rzele/TCC-Caixa-Preta/schemas/CXP 1p3/CXPcimaEbaixo3d.png

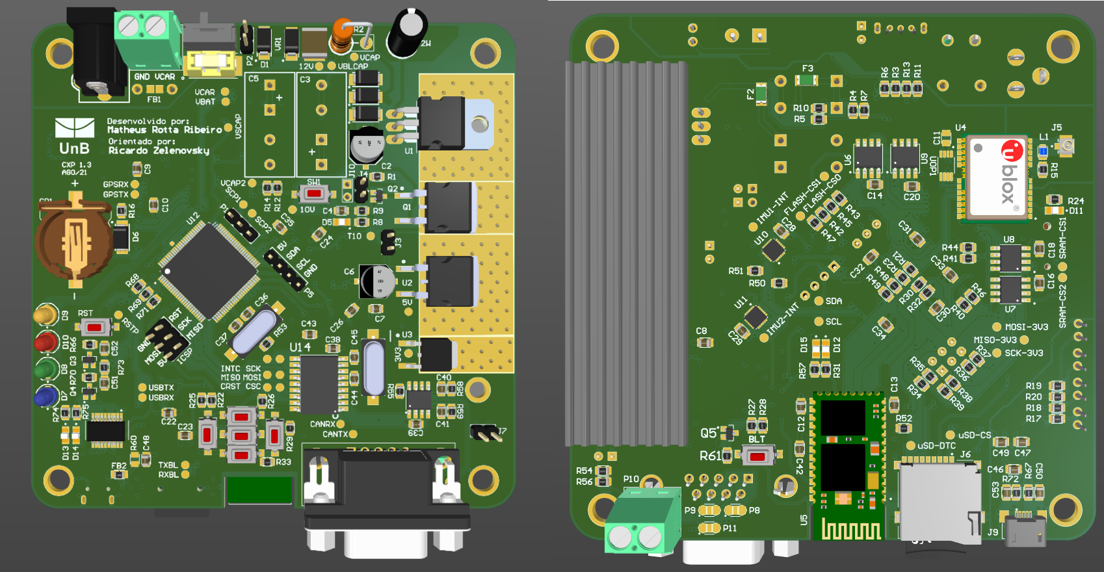
schemas/CXP 1p3/CXPcimaEbaixo3d.png
