rzele/TCC-Caixa-Preta/docs/Docs-2022/CXP.docx

CXP – Programa Caixa Preta (04/08/2020)

São duas as opções principais: Operação e Teste.

Operação: Ao ligar, entra normalmente em operação. Permite escolher um tipo de Operação para a Caixa Preta.

Teste: Entra em Teste se ligar a Caixa Preta com a tecla SEL acionada. Permite escolher rotinas para testar os diversos dispositivos da Caixa Preta e fazer novos ensaios.

Tudo pode ser comandado pela porta serial (eu espero!). Os comandos são letras (maiúsculas ou minúsculas) e números. O terminal do Arduino só os envia após o <Enter>.

Comandos seriais

Modo | Letra
- | T | Vai para o modo Teste
- | O | Vai para o modo Opera
- | Número | Inicia a opção com esse número
Opera 1: Adquirir dados | S | Inicia a aquisição (corresponde ao botão SEL)
| I | Interrompe a aquisição (corresponde ao INF)
| X | Sai do modo aquisição

----------------------- Distribuição da SRAM de 256 KB ---------------------------------

SRAM = 256 KB = 262.144

Mensagem GPS = 128 Bytes

Mensagem MPU = 18 bytes

Configuração = 416 bytes

Qtd msg MPU = 12.720 → 12.720 * 18 = 228.960 Bytes (127,2 segundos)

Qtd msg GPS = 254 → 254 * 128 = 32.768 Bytes (256 segundos)

262.144 – (256+32.768 + 228.960) = 160 bytes sobrando

Mapa da SRAM:

Finalidade | Faixa Hexa | Bytes | Qtd msg | Tempo
MPU | 0 0000 → 3 7E5F | 228.960 | 12.720 | 127 seg
Configuração | 3 7E60 → 3 7FFF | 416 | - | -
GPS | 3 8000 → 3 FFFF | 32.768 | 256 | 256 seg

#define MPU_ADR_INI 0x00000L

#define MPU_ADR_FIM 0x37E60L

#define CXP_ADR_INI 0x37E60L

#define CXP_ADR_FIM 0x38000L

#define GPS_ADR_INI 0x38000L

#define GPS_ADR_FIM 0x40000L

Unificação das Portas Seriais UART0 e UART2

UART0 --> Arduino

UART1 -->

UART2 --> Bluetooth

UART3 --> GPS

A CXP enxerga somente um canal serial.

Chegada: Não importa se vem de COM0 ou COM2, o dado é colocado na mesma fila.

Saída: toda vez que enviar um dado, ele sai pelas COM0 e COM2.

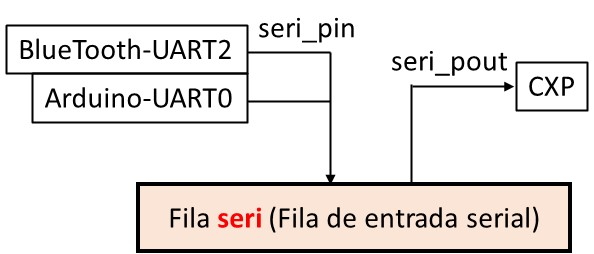
[picture p2: figure]
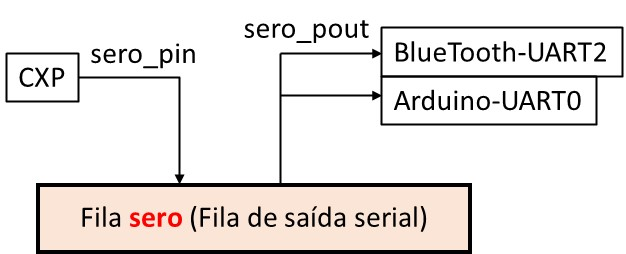
[picture p3: figure]

byte seri_fila[SERI_FILA_TAM] byte seri_pin,seri_pout byte seri_parou; void seri_config(void); byte seri_poe(byte dado) byte seri_tira (byte &dado) void seri_cheia(void) | byte sero_fila[SERO_FILA_TAM] byte sero_pin,sero_pout byte sero_parou; void sero_config(); byte sero_poe(byte dado) byte sero_tira (byte &dado) void sero_cheia(void)

--- SERI ---

Na chegada, interrupção da UART0 ou da UART2 chama seri_poe() e põe na fila. Não importa de onde veio.

Na saída, CXP usa seri_tira(), que deve desabilitar interrupções para tirar da fila.

--- SERO ---

Na chegada, CXP chama sero_poe(), para por algo na fila de saída (desabilitar interrupções para por na fila).

Na saída, Timer sempre reinicia a transmissão que acontece por interrupção até a fila esvaziar.

Interrupção TX UART0:

sero_cont++;

if (sero_cont==2){

if (sero_tira(&x) == TRUE){

UDR0=x; UDR2=x;

sero_parou=FALSE ; sero_cont=0;

}

else Sero_parou=TRUE;

}

Interrupção TX UART2:

Sero_cont++;

if (sero_cont==2){

if (sero_tira(&x) == TRUE){

UDR0=x; UDR2=x;

Sero_parou=FALSE; Sero_cont=0;

}

else sero_parou=TRUE;

}

Note que são duas unidades de saída UDR0 e UDR2. O dado a ser enviado é escrito em ambas. Um novo dado só pode ser enviado se ambas terminaram o envio anterior. A variável sero_cont garante isso, ela é zerada cada vez que um dado é escrito em UDR0 e UDR2. A primeira que termina incrementa sero_cont, que vai para 1. A segunda, ao terminar incrementa sero_cont, que vai para 2 e é autorizada a escrever novo dado a ser transmitido e zera a variável.

Quanto a fila sero fica vazia, sero_tira(&x) == FALSE então a transmissão deve parar por falta de dado. Mas faz a variável sero_parou=TRUE . O timer, se encontra a sinalização de que SERO parou, verifica se tem novo dado para retirar da fila, caso positivo, retira o dado e o escreve em UDR0 e UDR2, faz sero_parou=FALSE.

TIMER:

if sero_parou == TRUE{

if (sero_tira(&x) == TRUE){

UDR0=x; UDR2=x;

Sero_parou=FALSE Sero_cont=0;

}

else{

Sero_parou=TRUE; //Não precisa dessa linha

}

}

CALIBRAÇÃO DE FÁBRICA (CF)

É armazenada na EEPROM = 4 KB = 4.069 do processador AVR

Por Calibração de Fábrica se entendem parâmetros importantes para o funcionamento e que o usuário não vai alterar.

Uma calibração importante é a do erro intrínseco do MPU. Vamos deixá-lo ligado por um longo tempo (10 minutos) em um local estável, perfeitamente na horizontal, e depois fazer 1024 medidas espaçadas de acordo com a frequência da amostragem, calcular o erro intrínseco de cada eixo. Será importante armazenar o local onde foi feita a calibração e a aceleração da gravidade neste local.

Tabela na EEPROM com os dados da Calibração de Fábrica

(Todas strings são terminadas com zero ‘\0’)

(Valores de 16 ou 32 bits, grava-se primeiro o MSB “Big Endian”)

Bytes | Tipo | Exemplo | Nome | Descrição
| | | | Local e aceleração da gravidade
2 | 16 bits | SS | CF_OK | SS = já fez calibração, do contrário não
14 | string | dd/mm/aa | CF_DATA | Data da configuração
32 | string | Brasilia | CF_LOCAL | Local da configuração
16 | string | 9,80665 | CFG_PADRAO | Ac. da gravidade padrão (1g)
16 | string | 9,7808439 | CFG_LOCAL | Ac. da gravidade (m/s²) no local da configuração
2 | 16 bits | 0x3FFF | CFG_PADRAO_BIN | Ac. da gravidade padrão na escala de +/- 2g do MPU
2 | 16 bits | 0x3FD5 | CFG_LOCAL_BIN | Ac. da gravidade local na escala de +/- 2g do MPU
2 | 16 bits | 0x75 | CF_WHO | Resposta ao Who am I
- | - | - | - | Médias e Parâmetros usados
2 | 16 bits | 100 | CF_FA | Freq de amostragem usada (110, 200, ..., 1000)
2 | 16 bits | | CF_BW | Banda passante do filtro (5, 10, 21, ..., 260 Hz)
2 | 16 bits | | CF_ESC_AC | Escala usada para o Acelerômetro (2, 4, 8, 16)
2 | 16 bits | | CF_ESC_GI | Escala usada p/ o Giroscópio (250, 500, 1000, 2000)
2 | 16 bits | | CF_QTD | Quantidade de medidas para calcular a média
2 | 16 bits | | CF_AX | Erro do eixo ax (média)
2 | 16 bits | | CF_AY | Erro do eixo ay (média)
2 | 16 bits | | CF_AZ | Erro do eixo az (média) – ? descontado g local?
2 | 16 bits | | CF_TP | Temperatura média durante o cálculo
2 | 16 bits | | CF_GX | Erro do eixo gx (média)
2 | 16 bits | | CF_GY | Erro do eixo gy (média)
2 | 16 bits | | CF_GZ | Erro do eixo gz (média)
- | - | - | - | Somatórios
4 | 32 bits | | CF_AX_SOMA | Somatório no eixo ax
4 | 32 bits | | CF_AY_SOMA | Somatório no eixo ay
4 | 32 bits | | CF_AZ_SOMA | Somatório no eixo az
4 | 32 bits | | CF_TP_SOMA | Somatório das temperaturas
4 | 32 bits | | CF_GX_SOMA | Somatório no eixo gx
4 | 32 bits | | CF_GY_SOMA | Somatório no eixo gy
4 | 32 bits | | CF_GZ_SOMA | Somatório no eixo gz
- | - | - | - | Primeira e última medidas
2 | 16 bits | | CF_AX_PRI | Primeira medida no eixo ax
2 | 16 bits | | CF_AY_PRI | Primeira medida no eixo ax
2 | 16 bits | | CF_AZ_ PRI | Primeira medida no eixo ax
2 | 16 bits | | CF_TP_ PRI | Primeira medida de temperatura
2 | 16 bits | | CF_GX_ PRI | Primeira medida no eixo gx
2 | 16 bits | | CF_GY_ PRI | Primeira medida no eixo gy
2 | 16 bits | | CF_GZ_ PRI | Primeira medida no eixo gz
2 | 16 bits | | CF_AX_ULT | Última medida no eixo ax
2 | 16 bits | | CF_AY_ULT | Última medida no eixo ay
2 | 16 bits | | CF_AZ_ ULT | Última medida no eixo ax
2 | 16 bits | | CF_TP_ ULT | Última medida de temperatura
2 | 16 bits | | CF_GX_ ULT | Última medida no eixo gx
2 | 16 bits | | CF_GY_ ULT | Última medida no eixo gy
2 | 16 bits | | CF_GZ_ ULT | Última medida no eixo gz
- | - | - | - | Self Test
2 | 16 bits | | CF_ST_OK | Passou no Self-test? (TRUE=OK e FALSE=NOK)
2 | 16 bits | | CF_ST_OFF_AX | Leitura do eixo ax com Self Test desligado
2 | 16 bits | | CF_ST_OFF_AY | Leitura do eixo ay com Self Test desligado
2 | 16 bits | | CF_ST_OFF_AZ | Leitura do eixo az com Self Test desligado
2 | 16 bits | | CF_ST_OFF_GX | Leitura do eixo gx com Self Test desligado
2 | 16 bits | | CF_ST_OFF_GY | Leitura do eixo gy com Self Test desligado
2 | 16 bits | | CF_ST_OFF_GZ | Leitura do eixo gz com Self Test desligado
2 | 16 bits | | CF_ST_ON_AX | Leitura do eixo ax com Self Test ligado
2 | 16 bits | | CF_ST_ON_AY | Leitura do eixo ay com Self Test ligado
2 | 16 bits | | CF_ST_ON_AZ | Leitura do eixo az com Self Test ligado
2 | 16 bits | | CF_ST_ON_GX | Leitura do eixo gx com Self Test ligado
2 | 16 bits | | CF_ST_ON_GY | Leitura do eixo gy com Self Test ligado
2 | 16 bits | | CF_ST_ON_GZ | Leitura do eixo gz com Self Test ligado
2 | 16 bits | | CF_ST_REG_AX | Leitura do Reg de Self Test para ax (8 bits)
2 | 16 bits | | CF_ST_REG_AY | Leitura do Reg de Self Test para ay (8 bits)
2 | 16 bits | | CF_ST_REG_AZ | Leitura do Reg de Self Test para az (8 bits)
2 | 16 bits | | CF_ST_REG_GX | Leitura do Reg de Self Test para gx (8 bits)
2 | 16 bits | | CF_ST_REG_GY | Leitura do Reg de Self Test para gy (8 bits)
2 | 16 bits | | CF_ST_REG_GZ | Leitura do Reg de Self Test para gz (8 bits)
2 | 16 bits | | CF_ST_TOL_AX | Resultado calibração ax, tolerância de 14%
2 | 16 bits | | CF_ST_ TOL _AY | Resultado calibração ay, tolerância de 14%
2 | 16 bits | | CF_ST_ TOL _AZ | Resultado calibração az, tolerância de 14%
2 | 16 bits | | CF_ST_ TOL _GX | Resultado calibração gx, tolerância de 14%
2 | 16 bits | | CF_ST_ TOL _GY | Resultado calibração gy, tolerância de 14%
2 | 16 bits | | CF_ST_ TOL _GZ | Resultado calibração gz, tolerância de 14%
- | - | - | - | Magnetômetro – Calibração
2 | 16 bits | SS | CF_MAG_OK | SS = já fez calibração do magnetômetro
2 | 16 bits | | CF_STH_OK | Mag Passou no Self-test? (TRUE=OK e FALSE=NOK)
2 | 16 bits | | CF_STH_HX | Leitura de hx durante Self Test
2 | 16 bits | | CF_STH_HY | Leitura de hy durante Self Test
2 | 16 bits | | CF_STH_HZ | Leitura de hz durante Self Test
2 | 16 bits | | CF_HX_ASA | ASA de hx, Fuse ROM adjustment sensibility
2 | 16 bits | | CF_HY_ASA | ASA de hy, Fuse ROM adjustment sensibility
2 | 16 bits | | CF_HZ_ASA | ASA de hz, Fuse ROM adjustment sensibility
2 | 16 bits | | CF_HX_OFF | Offset de hx (dividir por 10) Hard Iron
2 | 16 bits | | CF_HY_OFF | Offset de hy (dividir por 10) Hard Iron
2 | 16 bits | | CF_HZ_OFF | Offset de hz (dividir por 10) Hard Iron
2 | 16 bits | | CF_HX_ESC | Escala de hx (dividir por 10) Soft Iron
2 | 16 bits | | CF_HY_ESC | Escala de hy (dividir por 10) Soft Iron
2 | 16 bits | | CF_HZ_ESC | Escala de hz (dividir por 10) Soft Iron

Note que as medidas CF_ST_REG_AX, ..., CF_ST_REG_GZ só precisam de 8 bits, mas foram reservados 16 bits para facilitar a leitura e o mapa.

As temperaturas inicial e final permitem ver se houve grande variação de temperatura durante a calibração

Ajustes do Magnetômetro:

ASAX, ASAY, ASAZ: Sensitivity Adjustment values (ASA tem apenas 1 byte e parece não ter sinal). Exemplo para hx, idem para hy e hz.

hx_(adj) =hx*(((ASAx-128)*0.5)/128+1)

CALIBRAÇÃO: Para ter um pouco de precisão, os valores de offset e ajuste estão multiplicados por 10. Então, primeiro é preciso dividi-los por 10 antes de usá-los.

hx_(aj) =(hx-hx_(off) )*hx_(esc)

hy_(aj) =(hyx-hy_(off) )*hy_(esc)

hz_(aj) =(hz-hz_(off) )*hz_(esc)

CALIBRAÇÃO AO LIGAR O CARRO

Toda vez que o carro for ligado, é executada a chamada “Calibração ao ligar o carro”. Ela será guardada na SRAM e copiada para a Flash em caso de acidente. Na SRAM (ou Flash) ocupa o bloco de 416 bytes (0x3 7E60 → 0x3 7FFF). Este bloco é marcado com as constantes:

#define CXP_ADR_INI 0x37E60L //Início área de config da Caixa Preta (sobram 416 bytes)

#define CXP_ADR_FIM 0x38000L //Fim área de conficuração da Caixa Preta

Para simplificar os acessos, os dados gravados nesta área são de 16 bits, 32 bits ou strings terminadas em zero. Mesmo quando a informação é de apenas um byte, usam-se 2 bytes. As duas constantes abaixo padronizam em 16 bits as possibilidades de sim ou não.

#define COD_SIM 0x5353 //2x ASCII(S) Afirmativo

#define COD_NAO 0x4E4E //2x ASCII(N) Negativo

Tabela 1. Parâmetros do Setor de Configuração ao Ligar e Operação (SRAM e FLASH).

Offset | Bytes | Tipo | Exemp | Nome | Descrição
0 | 2 | 16 bits | NN | OP_OK | Fez calibração ao ligar? OK / NOK
0 | 2 | 16 bits | NN | OP_BATEU | (NN) → pronta, (SS) → acidentada
2 | 2 | 16 bits | SS | OP_ST_OK | Self-Test: (SS) → OK, (NN) → NOK
2 | 2 | 16 bits | SS | OP_STH_OK | Self-Test Mag: (SS) → OK, (NN) → NOK
2 | 2 | 16 bits | SS | OP_CF_OK | Calib de Fabr: (SS) → OK, (NN) → NOK
2 | 2 | 16 bits | SS | OP_CFH_OK | Mag fez Calib de Fabr: OK, NOK
- | - | | | | Acel e Giro - Calibra ao ligar
4 | 2 | 16 bits | | OPC_FREQ_AG | Freq de amostragem (100,..., 1000 Hz)
4 | 2 | 16 bits | | OPC_BW_AG | Banda do filtro (5,10, ..., 260 Hz)
6 | 2 | 16 bits | | OPC_ESC_AC | Escala acelerômetro (1, 2, 4, 8 g)
6 | 2 | 16 bits | | OPC_ESC_GI | Escala giroscópio (250, ..., 2000)
4 | 2 | 16 bits | | OPC_QTD_AG | Qtd de medidas para a média
8 | 2 | 16 bits | | OPC_AX | Média AX
10 | 2 | 16 bits | | OPC_AY | Média AY
12 | 2 | 16 bits | | OPC_AZ | Média AZ
14 | 2 | 16 bits | | OPC_TP | Média TP
16 | 2 | 16 bits | | OPC_GX | Média GX
18 | 2 | 16 bits | | OPC_GY | Média GY
20 | 2 | 16 bits | | OPC_GZ | Média GZ
- | - | | | | Magnet - Calibra ao ligar
22 | 2 | 16 bits | | OPC_QTD_MG | Qtd de medidas para a média
24 | 2 | 16 bits | | OPC_ESC_MG | Escala do magnetômetro
26 | 2 | 16 bits | | OPC_HX | Média HX
28 | 2 | 16 bits | | OPC_HY | Média HY
30 | 2 | 16 bits | | OPC_HZ | Média HZ
- | - | | | | Acel, Giro e Mag - Operação
32 | 2 | 16 bits | | OP_FREQ_AG | Freq de amostragem (100,..., 1000 Hz)
4 | 2 | 16 bits | | OP_BW_AG | Banda do filtro (5,10, ..., 260 Hz)
32 | 2 | 16 bits | | OP_ESC_AC | Escala acelerômetro (1, 2, 4, 8 g)
34 | 2 | 16 bits | | OP_ESC_GI | Escala giroscópio (250, ..., 2000)
36 | 2 | 16 bits | | OP_ESC_MG | Escala Magnetômetro
38 | 2 | 16 bits | | OP_LIM_AX | Limiar disparo AX (valor absoluto)
40 | 2 | 16 bits | | OP_LIM_AY | Limiar disparo AY (valor absoluto)
44 | 2 | 16 bits | | OP_LIM_AZ | Limiar disparo AZ (valor absoluto)
46 | 2 | 16 bits | | OP_LIM_GX | Limiar disparo GX (valor absoluto)
48 | 2 | 16 bits | | OP_LIM_GY | Limiar disparo GY (valor absoluto)
50 | 2 | 16 bits | | OP_LIM_GZ | Limiar disparo GZ (valor absoluto)
- | - | | | | Quem Disparou ?
52 | 4 | 32 bits | | OP_MPU_ADR | Endereço MPU na SRAM do disparo
52 | 4 | 32 bits | | OP_GPS_ADR | Endereço GPS na SRAM do disparo
52 | 2 | 16 bits | | OP_DISP_TP | Temperatura no instante do disparo
52 | 2 | 16 bits | NN | OP_DISP_AX | AX Disparou (SS = sim, NN = não)
54 | 2 | 16 bits | NN | OP_DISP_AY | AY Disparou (SS = sim, NN = não)
56 | 2 | 16 bits | NN | OP_DISP_AZ | AZ Disparou (SS = sim, NN = não)
58 | 2 | 16 bits | NN | OP_DISP_GX | GX Disparou (SS = sim, NN = não)
60 | 2 | 16 bits | NN | OP_DISP_GY | GY Disparou (SS = sim, NN = não)
62 | 2 | 16 bits | NN | OP_DISP_GZ | GZ Disparou (SS = sim, NN = não)
62 | 2 | 16 bits | NN | OP_BRK | Aquisição interrompida (SS,NN)
62 | 4 | 32 bits | NN | OP_ULT_ADR | Último endereço gravado pelo MPU
- | - | | | | Data e Hora acidente (gps_dados)
64 | 8 | String | | OP_AC_DATA | Data do acidente: ddmmyy0
72 | 12 | String | | OP_AC_HORA | Hora do acidente: hhmmss.sss0
84 | 73 | Char | | | 0xFF
... | ... | Char | | | 0xFF
415 | 415 | Char | | | 0xFF

Sugestão para comunicação com a Caixa Preta (ainda por fazer)

Cmdo. | Param. | Descrição
? | - | Enviar configuração.
I | - | Inverter estado acidentado (T → F ou de F→T)
R | - | Zerar toda a Flash
L | - | Ler toda a memória
X | n | Limiar acelerômetro eixo X
Y | n | Limiar acelerômetro eixo Y
Z | n | Limiar acelerômetro eixo Z
x | n | Limiar giroscópio eixo X
y | n | Limiar giroscópio eixo Y
z | n | Limiar giroscópio eixo Z

Funções

void | setup | (void)
void | loop | (void)
byte | sel_modo | (char *msg[], byte total)

- void setup (void)
- void loop (void)
- byte sel_modo (char *msg[], byte total)

Retorna o número da opção selecionada. Recebe um vetor de ponteiros para as mensagens de cada opção e o total de opções. É usada para selecionar o modo de Operação e o tipo de Teste.

Defs.h

// TESTE

#define TESTE_TOT 17 //Modos de teste: 1, 2 , ..., 17

#define TESTE_0 0 //Opera

#define TESTE_1 1 //LEDs

#define TESTE_2 2 //LCD

#define TESTE_3 3 //Teclado

#define TESTE_4 4 //TWI

#define TESTE_5 5 //Acel e giro

#define TESTE_6 6 //Magnetometro

#define TESTE_7 7 //SRAM

#define TESTE_8 8 //FLAH

#define TESTE_9 9 //GPS Tudo

#define TESTE_10 10 //GPS RMC GSA

#define TESTE_11 11 //GPS U-Center

#define TESTE_12 12 //MPU-->Matlab

#define TESTE_13 13 //BlueTooth

#define TESTE_14 14 //Livre

#define TESTE_15 15 //Livre

#define TESTE_16 16 //Livre

#define TESTE_17 17 //Livre

// OPERA

#define OPERA_TOT 9 //Modos de teste: 1, 2 , ..., 9

#define OPERA_0 0 //Teste

#define OPERA_1 1 //Aqusição de Dados

#define OPERA_2 2 //Livre

#define OPERA_3 3 //Livre

#define OPERA_4 4 //Livre

#define OPERA_5 5 //Calibração de Fábrica

#define OPERA_6 6 //Calibração do Magnetômetro

#define OPERA_7 7 //Livre

#define OPERA_8 8 //Livre

#define OPERA_9 9 //Livre

Globs.h

// TESTE - Mensagens do modo de teste

char *teste_msg[]={ "0-Vai para Opera", //0

"1-LEDs", //1

"2-LCD", //2

"3-Teclado", //3

"4-TWI (I2C)", //4

"5-Acel e giro", //5

"6-Magnetometro", //6

"7-SRAM", //7

"8-FLASH", //8

"9-GPS: Tudo", //9

"10-GPS: Interpreta", //10

"11-GPS:U-Center", //11

"12-MPU-->MatLab", //12

"13-Blue Tooth", //13

"14-BT - Cmds AT", //14

"15-Vazio", //15

"16-Vazio", //16

"17-Vazio"}; //17

// OPERA - Mensagens do modo de Operação

char *opera_msg[]={ "0-Vai para Teste", //0

"1-Adquirir Dados", //1

"2-Vazio", //2

"3-vazio", //3

"4-Vazio", //4

"5-Calibra Fab", //5

"6-Calibra Mag", //6

"7-Vazio", //7

"8-Vazio", //8

"9-Vazio"}; //9

CXP

// Selecionar o modo

// Serve selecionar modo de Operação

// Serve selecionar modo de Teste

// A linha 0 é preparada por quem chama

// Usa as linhas 1, 2 e 3

byte sel_modo(char *msg[], byte total){

char prov=total; //provisório = 1, 2, ..., OPERA_TOT

byte tecla,aux;

byte ser;

byte fase; //Indicar se estava recebendo nr pela serial

fase=0;

prov=0;

while(TRUE){

lcd_apaga_lin(1);

lcd_apaga_lin(2);

lcd_apaga_lin(3);

lcd_str(2,0,"-->");

aux=prov;

lcd_str(1,3,msg[aux++]);

if (aux>total) aux=0;

lcd_str(2,3,msg[aux]);

ser_str(msg[aux++]); ser_crlf(1);

if (aux>total) aux=0;

lcd_str(3,3,msg[aux]);

//Esperar tecla ou serial

while(TRUE){

if ( sw_tira(&tecla) == TRUE) break;

if (seri_letra(&ser) == TRUE) return ser;

if (seri_num8(&ser) == TRUE) return ser;

}

switch(tecla){

case SW_SUP: prov--; break;

case SW_INF: prov++; break;

case SW_SEL: if (++prov>total) prov=0;

return prov;

}

ser_crlf(1);

if (prov>total) prov=0;

if (prov==-1) prov=total;

}

}

Ideias sobre o projeto Caixa Preta

1g = 9,80665 m/s².

(INMETRO) Aceleração da gravida em Brasília (15°45'43.2"S 47°52'25.3"W) = 9,7808439 m/s².

https://www.researchgate.net/publication/282913685_Determinacao_Experimental_da_Aceleracao_da_Gravidade_com_Pendulo_Simples_e_Cameras_Digitais

Em Brasília estamos com 9,7808439/9,80665 = 99,7369%.

Com MPU na escala de +/- 2g, deveríamos ler: (32.768/2)*0,997369 = 16.341 = 0x3FD5.
