rzele/TCC-Caixa-Preta/src/matlab/dashboard/README.md

# Dashboard
Painel modular para visualização de dados e estimativas de inclinação.

A documentação de uso e extensão deste painel se encontra na pasta ```docs``` na raiz deste projeto.
