rzele/TCC-Caixa-Preta/src/matlab/dashboard/charts/example/README.md

## Como criar um gráfico
1. Crie uma cópia da pasta example
2. Renomeia a pasta, e o arquivo 'Example.m' (este deve ter o mesmo nome da classe, e seguir o padrão CamelCase)
3. Leia as instruções em Example.m
4. Faça as alterações necessária na sua classe 'chart'
5. Instâncie seu gráfico no arquivo 'Charts.m'
6. Adicione ele ao layout e execute a 'main.m'

## História
Originalmente existia uma classe do tipo 'Cálculo'
Que devia implementar todos os métodos descritos na interface 'Template.m'

O objetivo era que ela realiza-se contas para ser exibido na tela
utilizando uma das classes do tipo 'plot'

Porém a main tinha de gerenciar duas classes, 'calculo' e 'plot'
conectando as duas, instanciando as duas, e dizendo qual 'calculo' atualizaria qual 'plot'.

Para simplificar foi criado as classes híbridas, elas pode fingir ser do tipo 'plot'
e continuar sendo do tipo 'calculo', assim ela pode
- Ser inserida diretamente na tela
- Definir os parâmetros do gráfico, como cores e títulos, e qual tipo de gráfico será usado
- Fazer os cálculos que iram atualizar o gráfico na tela
assim fica a encargo da main somente chamar a função de calcular, já que não há necessidade de conecta-las

A esta classe híbrida chamamos 'chart'.

Para simplificar novamente, muitos dos métodos definidos no template da classe 'calculo',
são implementados da mesma forma por muitos 'charts'. Por isso foi criado algumas classes com implementações padrões para cada tipo de gráfico, como:
- Herdar a interface e o tipo 'plot' que será utilizado
- Implementar alguns métodos, como os gets que retornam o dado calculado
- Definir alguns atributos em comum
