rzele/TCC-Caixa-Preta/docs/Docs-2022/Opera.docx

Caixa Preta no Modo Operação

Versão 1.0, 14/02/2020

Opções de Operação

Nr | Nome | O que faz
1 | Vazio
2 | Vazio
3 | Vazio
4 | Vazio
5 | Ensaio | Ensaio
6 | Caixa Preta Alfa | Operação normal da Caixa Preta
7 | Calibra Fab | Calibração de Fábrica

// OPERA - Mensagens do modo de Operação

char *opera_msg[]={ "0-Vai para Teste", //0

"1-Adquirir Dados", //1

"2-Vazio", //2

"3-vazio", //3

"4-Vazio", //4

"5-Calibra Fab", //5

"6-Calibra Mag", //6

"7-Vazio",; //7

"8-Vazio",; //8

"9-Vazio"}; //9

A função byte sel_modo( ) permite fazer a seleção entre as opções

Opera 1 – Coleta de dados.

Opera 2 – Vazio.

Opera 3 – Vazio.

Opera 4 – Vazio.

Opera 5 – Calibração de Fábrica (CF)

Opera 6 – Calibração Magnetômetro

Opera 7 – Vazio.

Opera 8 – Vazio.

Opera 9 – Vazio.

Opera 1 – Geração e Coleta de Dados

Modo de operação para facilitar a geração e coleta de dados.

Ao entrar neste modo e já começa a armazenar, ciclicamente, dados do MPU e do GPS. Isso é bom porque vai preenchendo memória do GPS. Um ciclo na memória dedicada ao MPU dura 127 seg.

‘S’ ou SEL → (re)inicia aquisição = BATEU

‘I’ ou INF → abrevia aquisição

‘X’ ou SEQ1 → sai do modo opera

Durante aquisição, exibe contador de tempo restante. Ao completar o ciclo, interrompe a aquisição e começa a enviar os dados pela porta serial. Ao terminar o envio, volta a esperar a tecla SEL para uma nova gravação. A tecla SEL pode interromper a aquisição.

MPU: 228.960 bytes → 127 seg (228.960/18=12.720, taxa de 100 sps = 127,2 seg).

GPS: 32.768 bytes → 256 seg.

dxxx$.txt – Arquivo principal

Este arquivo deve conter todos os dados da CXP que possam ser úteis para a análise. Em suma, aqui está tudo que se pode extrair da CXP. É um arquivo texto, sendo que o final de cada linha é indicado com caracteres Carriage Return (0xD) e Line Feed (0xA). Quando uma linha tem vários dados, eles são separados por 1 ou mais espaços. Tolera-se linhas em branco para fazer a separação de campos importantes. São 4 os marcadores de campo usados para delimitar esses dados.

#[m ... m]# → início e fim do campo de dados do MPU

#[g ... g]# → início e fim do campo de dados do GPS

#[l ... l]# → início e fim do campo de dados com os resultados da Calibração ao Ligar

#[f ... f]# → início e fim do campo de dados com os resultados da Calibração de Fábrica

Observações:

a) Deve ficar claro que o delimitador #[m caracteriza o início do campo útil do arquivo. Isto significa que tudo que estiver antes deste delimitador deve ser ignorado pelo programa de pós-processamento.

b) Deve ficar claro que o delimitador f]# caracteriza o fim do campo útil do arquivo. Isto significa que tudo que estiver após este delimitador deve ser ignorado pelo programa de pós processamento.

c) Tudo o que estiver entre o delimitador final de um campo e o delimitador de início do campo seguinte deve ser ignorado pelo programa de pós-processamento. Por exemplo, tudo que estiver entre o m]# e #[g deve ser ignorado pelo de programa de pós processamento.

d) O programa de pós-processamento faz um “rewind” antes de buscar por cada campo, assim esses campos podem estar em qualquer ordem.

Esboço de um arquivo principal (dxxx$.txt)

#[m → indica que começa a enviar MPU

Data → data do acionamento de SEL (vem do GPS)

Hora → Hora do acionamento de SEL (vem do GPS)

Temp → Temperatura no instante do acidente

Adr_mpu → posição do ponteiro memória MPU quando SEL foi acionado

Adr_gps → posição do ponteiro memória GPS quando SEL foi acionado

Qtd → quantidade de medidas do MPU (linhas ax, ay, ..., hz)

cf_ok st_cf aesc_cf gesc_cf tp_cf ax_off ay_off az_off gx_off gy_off gz_off

cfh_ok sth_cf hx_asa hy_asa hz_asa hx_off hy_off hz_off hx_esc hy_esc hz_esc

st_op sth_op aesc_op gesc_op famost bw r1 r2 r3 r4 r5

cont adr ax ay az gx gy gz hx hy hz

cont adr ax ay az gx gy gz hx hy hz

m]#

#[g → indica que começa a enviar GPS

Data → data do acionamento de SEL (vem do GPS)

Hora → Hora do acionamento de SEL (vem do GPS)

Adr → posição do ponteiro memória GPS quando SEL foi acionado

Qtd → quantidade de medidas do GPS

cont adr [--- msg do GPS ---]

cont adr [--- msg do GPS ---]

g]#

#[l

Calibração ao ligar

l]#

#[f

Calibração de fábrica

f]# →

Exemplo de um arquivo principal (dxxx$.txt).

Note que as linhas do GPS estão quebradas por falta de espaço no editor

#[m

290720 = data

181733 = hora

2402 = temperatura

20046 = self test acel e giro

20046 = self test mag

5040 = ponteiro MPU na hora da batida

229888 = ponteiro GPS na hora da batida

+21331 +20046 +2 +250 +2111 +544 +232 +17905 +124 +112 +62

+21331 +181 +181 +183 +171 -100 +2005 -680 +1940 +3255 +3230

+20046 +20046 +2 +250 +100 +5 +1 +2 +3 +4 +5

259 = quantidade de linhas
00000 00003C30 00808 01056 13060 65368 00104 65446 65535 65535 65535

00001 00003C42 00816 01028 13216 65325 00116 65444 65535 65535 65535

00002 00003C54 00716 01032 13032 65295 00122 65445 65535 65535 65535

12717 00003BFA 00584 00988 13172 65193 00133 65477 65535 65535 65535

12718 00003C0C 00604 00972 13252 65194 00134 65480 65535 65535 65535

12719 00003C1E 22222 22222 22222 22222 22222 22222 65535 65535 65535

m]#

#[g

290720 = data

181733 = hora

229888 = ponteiro GPS na hora da batida

256 = quantidade de linhas

0000000000 +0000246784 A 21/05/20 12:35:24 1548.63020S 04748.65727W 1.203K 0.649 1065.9M [04 6.54 3.24 5.68] 15246
...

0000000255 +0000246656 A 21/05/20 12:35:23 1548.63031S 04748.65770W 0.687K 0.371 1066.1M [06 6.54 3.24 5.68] 13464

g]#

#[l

21331

20046

…

123316.00

l]#

#[f

+21331

20/04/20

...
-00006 -00018 -00004 +00180 -00543 +00188

f]#

Detalhamento dos dados presentes no arquivo principal (dxxx$.txt). Todos os dados são strings ASCII delimitados por espaços em branco ou fim de linha (0xD 0xA).

Linha | Descrição
| ------- dados do MPU ------
#[m | Delimitador de início do campo de dados do MPU.

ddmmyy | Data da batida (do acionamento da tecla SEL) (string).
hhmmss | Hora da batida (do acionamento da tecla SEL) (string).
temp | Leitura do registrador de temperatura na hora do acidente.
st_op | Resultado do Self Test ao ligar (acelerômetro e giroscópio)
sth_op | Resultado do Self Test ao ligar (magnetômetro)
adr_mpu | Ponteiro de gravação dos dados do MPU na hora da batida.
adr_gps | Ponteiro de gravação dos dados do GPS na hora da batida.

cf_ok

1.Calibração de Fábrica foi realizada? (sim = 21.331= ‘SS’ e Não = 20.046 = ‘NN’)

2.Passou no Self Teste da Calibração de Fábrica? (sim = 21.331= ‘SS’ e Não = 20.046 = ‘NN’)

3.Escala do Acelerômetro na Calibração de fábrica (1, 2, 4, 8 g)

4.Escala do Giroscópio na Calibração de Fábrica (250, 500, ..., 2000 graus/seg)

5.Leitura do registrador de temperatura durante a Calibração de Fábrica

6.Offset de ax (Calibração de Fábrica)

7.Offset de ay (Calibração de Fábrica)

8.Offset de az (Calibração de Fábrica)

9.Offset de gx (Calibração de Fábrica)

10.Offset de gy (Calibração de Fábrica)

11.Offset de gz (Calibração de Fábrica)
st_cf
aesc_cf
gesc_cf
tp_cf
ax_off
ay_off
az_off
gx_off
gy_off
gz_off
cfh_ok | 1.Feita Calibração de Fábrica do Magnet? (sim = 21.331= ‘SS’ e Não = 20.046 = ‘NN’) 2.Passou Self Teste do Magnetômetro na CF? (sim = 21.331= ‘SS’ e Não = 20.046 = ‘NN’) 3.Ajuste do eixo hx 4.Ajuste do eixo hy 5.Ajuste do eixo hz 6.Offset de hx (Calibração de Fábrica) 7.Offset de hy (Calibração de Fábrica) 8.Offset de hz (Calibração de Fábrica) 9.Ajuste de escala de hx (Calibração de Fábrica) 10.Ajuste de escala de hy (Calibração de Fábrica) 11.Ajuste de escala de hz (Calibração de Fábrica)
sth_cf
hx_ASA
hy_ASA
hz_ASA
hx_off
hy_off
hz_off
hx_esc
hy_esc
hz_esc
st_op | 1. Passou Self Teste da Operação? (sim = 21.331= ‘SS’ e Não = 20.046 = ‘NN’) 2. Magnet passou Self Teste da Operação? (sim = 21.331= ‘SS’ e Não = 20.046 = ‘NN’) 3.Escala do Acelerômetro na Operação (1, 2, 4, 8 g) 4.Escala do Giroscópio na Operação (250, 500, ..., 2000 graus/seg) 5. Frequência de amostragem em Hz 6. BW usada na operação 7. Reserva 8. Reserva 9. Reserva 10. Reserva 11. Reserva
sth_op
aesc_op
gesc_op
famost
bw
r1
r2
r3
r4
r5
qtd | Quantidade de linhas com as informações do MPU (ax, ay, ..., hz).
cont adr ax ay ax gx gy gz hx hy hz | Linha com uma leitura do MPU. Todos esses dados estão em uma mesma linha, separados por espaços em branco. cont é um contador sequencial. adr é o endereço em decimal da posição onde este dado do MPU estava na SRAM.
m]# | Delimitador de fim do campo de dados do MPU
| ------- dados do GPS ------
#[g | Delimitador de início do campo de dados do GPS. Observação: Cada linha do GPS é composta por várias strings separadas por espaço em branco. Nesta tabela elas foram separados para facilitar a explicação.

ddmmyy | Data da batida (do acionamento da tecla SEL) (string).
hhmmss | Hora da batida (do acionamento da tecla SEL) (string).
adr_gps | Ponteiro de gravação dos dados do GPS na hora da batida.
qtd | Quantidade de linhas com as informações do GPS.
cont | Contador sequencial.
adr | Endereço em decimal da posição onde este dado do GPS estava na SRAM.
A/V | Uma letra para indicar se dado é válido (A) ou não válido (V).
ddmmyy | Data da leitura do GPS.
hhmmss | Hora da leitura do GPS.
ddmm.ffffff | Latitude em graus (degrees), minutos e frações de minuto
N/S | Indicação do hemisfério
dddmm.fffff | Longitude em graus (degrees), minutos e frações de minuto
E/W | Indicação do Este ou Oeste
x.xxx | Velocidade
K | Unidade da velocidade (K=km/h)
x.xxx | Velocidade em nós
x.xx | ??? curso
x.xx | Altitude
M | Unidade da altitude (M=metros)
xx | Quantidade de satélites
PDOP | Qualidade da medida
HDOP | Espalhamento horizontal
VDOP | Espalhamento vertical
adr_mpu | Endereço em decimal do ponteiro que grava os dados do MPU
g]# | Delimitador de fim do campo de dados do GPS
| ------- dados da Calibração ao Ligar ------ void sram_op_dados(void) void flash_op_dados(void)
#[l | Delimitador de início do campo da Calibração ao Ligar

OP_OK | Fez calibração ao ligar? OK / NOK
OP_BATEU | (NN) → pronta, (SS) → acidentada
OP_ST_OK | Self-Test: (SS) → OK, (NN) → NOK
OP_STH_OK | Self-Test Mag: (SS) → OK, (NN) → NOK
OP_CF_OK | Calib de Fabr: (SS) → OK, (NN) → NOK
OP_CFH_OK | Mag fez Calib de Fabr: OK, NOK
| Acel e Giro - Calibra ao ligar
OPC_FREQ_AG | Freq de amostragem (100,..., 1000 Hz)
OPC_BW_AG | Banda do filtro (5,10, ..., 260 Hz)
OPC_ESC_AC | Escala acelerômetro (1, 2, 4, 8 g)
OPC_ESC_GI | Escala giroscópio (250, ..., 2000)
OPC_QTD_AG | Qtd de medidas para a média
OPC_AX | Médias: AX AY AZ TP GX GY GZ
OPC_AY
OPC_AZ
OPC_TP
OPC_GX
OPC_GY
OPC_GZ
| Acel, Giro e Mag - Operação
OP_FREQ_AG | Freq de amostragem (100,..., 1000 Hz)
OP_BW_AG | Banda do filtro (5,10, ..., 260 Hz)
OP_ESC_AC | Escala acelerômetro (1, 2, 4, 8 g)
OP_ESC_GI | Escala giroscópio (250, ..., 2000)
OP_ESC_MG | Escala Magnetômetro (Não é usado)
OP_LIM_AX | Limiar de Disparo: AX AY AZ TP GX GY GZ (valor absoluto)
OP_LIM_AY
OP_LIM_AZ
OP_LIM_GX
OP_LIM_GY
OP_LIM_GZ
| Quem Disparou ?
OP_MPU_ADR | Endereço MPU na SRAM do disparo
OP_GPS_ADR | Endereço GPS na SRAM do disparo
OP_DISP_TP | Temperatura no instante do disparo
OP_DISP_AX | Quem disparou: AX AY AZ GX GY GZ (SS = sim, NN = não)
OP_DISP_AY
OP_DISP_AZ
OP_DISP_GX
OP_DISP_GY
OP_DISP_GZ
OP_BRK | Aquisição interrompida (SS,NN)
OP_ULT_ADR | Último endereço gravado pelo MPU
OP_AC_DATA | Data do acidente: ddmmyy0
OP_AC_HORA | Hora do acidente: hhmmss.sss0
l]#
| ------- dados da Calibração de Fábrica ------ byte eeprom_cf_dados(void)
#[f | Delimitador de início do campo da Calibração de Fábrica

CF_OK | SS = já fez calibração, do contrário não ? (21331 = SIM e 20046 = NÃO)
CF_DATA | Data da configuração (string)
CF_LOCAL | Local da configuração (string)
CFG_PADRAO | Ac. da gravidade padrão (1g) (string)
CFG_LOCAL | Ac. da gravidade (m/s²) no local da configuração (string)
CFG_PADRAO_BIN | Ac. da gravidade padrão na escala de +/- 2g do MPU
CFG_LOCAL_BIN | Ac. da gravidade local na escala de +/- 2g do MPU
CF_WHO | Resposta ao Who am I
- | Médias e Parâmetros usados
CF_FA | Freq de amostragem usada (110, 200, ..., 1000)
CF_BW | Banda passante do filtro (5, 10, 21, ..., 260 Hz)
CF_ESC_AC | Escala usada para o Acelerômetro (2, 4, 8, 16)
CF_ESC_GI | Escala usada p/ o Giroscópio (250, 500, 1000, 2000)
CF_QTD | Quantidade de medidas para calcular a média
CF_AX | Off Set: Médias ax ay az tp gx gy gz
CF_AY
CF_AZ
CF_TP
CF_GX
CF_GY
CF_GZ
- | Somatórios
CF_AX_SOMA | Somatórios para calcular as médias: ax ay az tp gx gy gz (32 bits)
CF_AY_SOMA
CF_AZ_SOMA
CF_TP_SOMA
CF_GX_SOMA
CF_GY_SOMA
CF_GZ_SOMA
- | Primeira e última medidas
CF_AX_PRI | Primeira medida: ax ay az tp gx gy gz
CF_AY_PRI
CF_AZ_ PRI
CF_TP_ PRI
CF_GX_ PRI
CF_GY_ PRI
CF_GZ_ PRI
CF_AX_ULT | Última medida: ax ay az tp gx gy gz
CF_AY_ULT
CF_AZ_ ULT
CF_TP_ ULT
CF_GX_ ULT
CF_GY_ ULT
CF_GZ_ ULT
- | Self Test
CF_ST_OK | Passou no Self-test? (TRUE=OK e FALSE=NOK)
CF_ST_OFF_AX | Leitura com Self Test Desligado: ax ay az gx gy gz
CF_ST_OFF_AY
CF_ST_OFF_AZ
CF_ST_OFF_GX
CF_ST_OFF_GY
CF_ST_OFF_GZ
CF_ST_ON_AX | Leitura com Self Test Ligado: ax ay az gx gy gz
CF_ST_ON_AY
CF_ST_ON_AZ
CF_ST_ON_GX
CF_ST_ON_GY
CF_ST_ON_GZ
CF_ST_REG_AX | Leitura do Reg de Self Test (8 bits): ax ay az gx gy gz
CF_ST_REG_AY
CF_ST_REG_AZ
CF_ST_REG_GX
CF_ST_REG_GY
CF_ST_REG_GZ
CF_ST_TOL_AX | Resultado calibração, tolerância de 14%: ax ay az gx gy gz
CF_ST_ TOL _AY
CF_ST_ TOL _AZ
CF_ST_ TOL _GX
CF_ST_ TOL _GY
CF_ST_ TOL _GZ
- | Magnetômetro – Calibração
CF_MAG_OK | SS = já fez calibração do magnetômetro
CF_STH_OK | Mag Passou no Self-test? (TRUE=OK e FALSE=NOK)
CF_STH_HX | Leitura durante Self Test: hx hy hz
CF_STH_HY
CF_STH_HZ
CF_HX_ASA | Fuse ROM adjustment sensibility (ASA) : hx hy hz ASA de hy, Fuse ROM adjustment sensibility
CF_HY_ASA
CF_HZ_ASA
CF_HX_OFF | Offset (dividir por 10) Hard Iron: hx hy hz
CF_HY_OFF
CF_HZ_OFF
CF_HX_ESC | Escala (dividir por 10) Soft Iron: hx hy hz
CF_HY_ESC
CF_HZ_ESC
f]# | Delimitador de fim do campo da Calibração de Fábrica

Padrão para os nomes dos Arquivos gerados

dxxxt.txt → Contém tudo, incluindo { #[m ... #[g ... #]f }.

dxxxa.txt → { ax ay az } Acelerômetro

dxxxg.txt → { gx gy gz } Giroscópio

dxxxh.txt → { hx hy hz } Magnetômetro

dxxxn.txt → { ... linha gps 128 bytes } GPS = navegador

dxxxp.txt → { Lat N/S Long E/W } Só latitude e longitude

dxxxv.txt → {velocidade km/h} Só a velocidade

Opera 6 – Caixa Preta Alfa

Primeira versão do programa Caixa Preta.

Faz todas as operações. A tecla SEL serve para indicar um acidente.

Grava tudo na Flash e depois apresenta os dados.

Opera 5 – Calibração de Fábrica (CF)

Faz a Calibração de Fábrica, armazenando os dados na EEPROM.

Esta calibração é feita uma única vez. Fica armazenada na EEPROM do processador. O usuário não tem acesso a ela. Ela faz as seguintes operações:

- Armazena os dados de aceleração de gravidade, padrão e do local onde foi feita a calibragem;
- Espera um longo tempo para o MPU aquecer e depois calcula a média de uma grande quantidade de medidas para determinar o erro intrínseco de cada eixo;
- Realiza o Self Test e guarda os resultados

// CONFIGURAÇÃO DE FÁBRICA

//Aceleração da Gravidade

#define G_PADRAO 9.80665 //1g padrão

#define G_BSB 9.7808439 //Ac. gravidade em Brasília

const char *CF_HOJE = "20/04/20"; //Data para Configuração de Fábrica

const char *CF_BSB = "Brasilia"; //Data para Configuração de Fábrica

- void opera_prepara (void)

Faz toda a preparação necessária para a operação da Caixa Preta.

- Zerar a SRAM;
- Configura MPU;
- Calibra ao ligar o carro;
- void calibra_fab (void)

Realiza a Calibração de Fábrica.

Opera 6 – Calibração Magnetômetro

Calibra o magnetômetro e envia os dados pela serial para gravação na EEPROM.
