rzele/TCC-Caixa-Preta/docs/dispositivo/Flash.docx

Biblioteca acesso à memória FLASH (24LC1025)

20/04/2020, versão 1.0

Faixas de endereços das memórias Flash (2 memórias de 128 KB cada)

Início | Fim | Flash | Bloco | Define | Define
0 0000 | 0 FFFF | 1 | 0 | FLASH1_ADR+0 | 0x50
1 0000 | 1 FFFF | 1 | 1 | FLASH1_ADR+4 | 0x54
2 0000 | 2 FFFF | 2 | 0 | FLASH2_ADR+0 | 0x51
3 0000 | 3 FFFF | 2 | 1 | FLASH2_ADR+4 | 0x55

As duas memórias flash vão trabalhar com uma só de 256 KB de 0x0 0000 até 0x3 FFFF.

A partir do endereço, a função seleciona onde ler.

Funções

void | flash_dados_acid | (void)
void | flash_op_mostra | (void)
void | flash_dump | (long adr, long qtd)
long | flash_rd_32b | (long adr)
void | flash_wd_32b | (long adr, long dado)
int | flash_rd_16b | (long adr)
void | flash_wr_16b | (long adr, int dado)
void | flash_rd_str | (long adr, byte *msg, word qtd)
void | flash_wr_str | (long adr, byte *msg)
void | flash_apg_blk | (long adr, byte qtd)
void | flash_rd_blk | (long adr, byte *vet, word qtd)
void | flash_wr_blk | (long adr, byte *vet, byte qtd)
byte | flash_rd | (long adr)
void | flash_wr | (long adr, byte dado)
byte | flash_qual | (long adr)
void | flash_espera | (long adr)

- void flash_dados_acid (void)

Serve para a Flash Batida. Apresentar todos os dados do acidente. Inclui GPS e MPU.

- void flash_op_mostra (void)

Mostrar configuração feita ao ligar o carro.

- void flash_dump (long adr, long qtd)

Dump da FLASH. Mostra qtd bytes a partir do endereço adr.

Usa a função ser_dump_memo (long adr, char *vet) para mostrar uma linha.

- long flash_rd_32b (long adr)

Ler um valor de 32 bits da FLASH, Big Endian.

- void flash_wr_32b (long adr, long dado)

Escrever um valor de 32 bits na FLASH, Big Endian.

- int flash_rd_16b (long adr)

Ler um valor inteiro de 16 bits da FLASH. Big Endian.

- void flash_wr_16b (long adr, int dado)

Escrever um valor inteiro de 16 bits da FLASH. Big Endian.

- void flash_rd_str (long adr, byte *msg, word qtd)

Ler uma string da FLASH. O ponteiro msg deve ter espaço adequado.

Qtd indica a quantidade máxima, o último byte é o zero final

- void flash_wr_str (long adr, byte *msg)

Gravar uma string na FLASH, terminada em zero.

- void flash_apg_blk (long adr, byte qtd)

(90) Preencher um determinado bloco com 0xFF.

qtd --> precisa estar dentro de página de 128 bytes.

Não é preciso apagar para gravar algo. Esta função é apenas como conveniência.

Usar a função void flash_espera(long adr) para ser avisado assim que a operação terminar.

- void flash_rd_blk (long adr, byte *vet, word qtd)

(80) Ler um bloco a partir de um endereço.

qtd --> não há limitação desde que fique dentro dos 16 bits (64 K).

- void flash_wr_blk (long adr, byte *vet, byte qtd)

(70) Escrever um bloco a partir de um endereço.

qtd --> precisa estar dentro de página de 128 bytes (apenas os 7 LSbits de endereço variam).

Usar a função void flash_espera(long adr) para ser avisado assim que a operação terminar.

- byte flash_rd (long adr)

(50) Ler um endereço da memória.

- byte flash_wr (long adr, byte dado)

(60) Escrever o dado no endereço adr da memória.

Usar a função void flash_espera(long adr) para ser avisado assim que a operação terminar.

- byte flash_qual (long adr)

Retornar endereço TWI (I2C) da flash a ser usada, em função do endereço a ser acessado.

#define FLASH1_ADR 0x50 //FLASH1

#define FLASH2_ADR 0x51 //FLASH2

  - 0 0000 --> 0 FFFF → retorna FLASH1_ADR+0 (0x50)
  - 1 0000 --> 1 FFFF → retorna FLASH1_ADR+4 (0x54)
  - 2 0000 --> 2 FFFF → retorna FLASH2_ADR+0 (0x51)
  - 3 0000 --> 3 FFFF → retorna FLASH2_ADR+5 (0x55)

Exemplo:

byte er,et;

er=flash_qual(endereço);

er=er<<1; //Endereço escravo receptor

et=et+1; //Endereço escravo transmissor

- void flash_espera (long adr)

(100) Esperar Flash terminar gravação no endereço adr.

Ficar acessando com WR até ela responder.

// Endereços da FLASH 24LC1025 (128 KB) TWI

#define FLASH1_ADR 0x50 //FLASH1

#define FLASH2_ADR 0x51 //FLASH2

#define FLASH1_ADR_B0 FLASH1_ADR+0 //FLASH1, Bloco 0: 64KB (0x00000 -> 0x0FFFF)

#define FLASH1_ADR_B1 FLASH1_ADR+4 //FLASH1, Bloco 1: 64KB (0x10000 -> 0x1FFFF)

#define FLASH2_ADR_B0 FLASH2_ADR+0 //FLASH2, Bloco 0: 64KB (0x00000 -> 0x0FFFF)

#define FLASH2_ADR_B1 FLASH2_ADR+4 //FLASH2, Bloco 1: 64KB (0x10000 -> 0x1FFFF)

#define FLASH_PAG 128 //Tamanho da página para gravação

GP RMC - Recebe uma string e se for RMC, a imprime.

Retorna TRUE se era RMC (imprime).

Retorna FALSE se não era (nada imprime).

Seq Vazia = $GPRMC,,V,,,,,,,,,,N*53

01234567890123456789012

- byte gps_gsa_ser (char *vt)

GP GSA - Recbe uma string e se for GSA, a imprime.

Retorna TRUE se era GSA (imprime).

Retorna FALSE se não era (nada imprime).

Seq Vazia = $GPGSA,A,3,,,,,,,,,,,,N*53

01234567890123456789012

- void gps_str (byte *msg)

Enviar msg para GPS.

- void gps_char (byte dt)

Enviar um char para o GPS.

Não usa interrupção.

- void gps_rx_fila_config (void)

Inicializar fila GPS RX serial.

- char gps_rx_poe (char cha)

Colocar um byte na fila RX do GPS.

- void gps_fila_rx_cheia (void)

Mensagem de Fila RX Cheia do GPS.

- char gps_rx_tira (char *cha)

Tirar um byte da fila RX do GPS.

- void gps_config (long br)

Configurar porta serial 3.

Não habilita TX e nem RX.

Não habilita interrupções.

- ISR(USART3_TX_vect)

TX3: Interrupção por dado enviado

- ISR(USART3_RX_vect)

RX3: Interrupção por dado recebido

volatile char gps_tx_fila[GPS_TX_FILA_TAM]; //Espaço para a fila serial de TX

volatile byte gps_tx_pin, gps_tx_pout; //Ponteiros para usar a fila

volatile byte gps_tx_ok; //Indica que terminou transmissão

volatile char gps_rx_fila[GPS_RX_FILA_TAM]; //Espaço para a fila serial de RX

volatile byte gps_rx_pin, gps_rx_pout; //Ponteiros para usar a fila

volatile byte gps_rx_ok; //Indica que terminou recepção

volatile byte gps_msg_0[200]; //(fase=0) Buffer 0 usado pela interrupção para receber GPRMC

volatile byte gps_msg_1[200]; //(fase=1) Buffer 1 usado pela interrupção para receber GPRMC

volatile byte gps_msg_ix; //Indexador para escrever nos buffers;

volatile byte gps_msg_fase; //Fase para receber GPRMC (0=gps_rmc_0 e 1=gps_rmc_1);

volatile byte gps_msg_ok; //Indica que completou o recebimento de uma mensagem;

GPRMC

$GPRMC,hhmmss,status,latitude,N,longitude,E,spd,cog,ddmmyy,mv,mvE,mode*cs<CR><LF>

$GPRMC,083559.00,A,4717.11437,N,00833.91522,E,0.004,77.52,091202,,,A*57

0 | 1 | 2 | 3 | 4 | 5 | 6
$GPRMC, | hhmmmss.sss, | Stat, | Lat:ddmm.mmmmm, | N/S, | Long:dddmm.mmmmm, | E/W,
$GPRMC, | 083559.00, | A, | 4717.11437, | N, | 00833.91522, | E,
7 | 12 | 2 | 11 | 2 | 12 | 2

7 | 8 | 9 | 10 | 11 | 12 | 13 | 14
Speed:ddd.ddd, | Curso:ddd.ddd, | Data:ddmmyy | Mv, | mvE, | Modo | *Check | CR LF
0.004, | 77.52, | 091202, | , | , | A | *57 | 0xD 0xA
?8 | ?8 | 7 | ?8 | ?2 | 1 | 3 | 2

Tamanh0 = 80 bytes, vou usar tamanho 100.

Lido com Arduino: $GPRMC,131732.00,A,1548.62581,S,04748.65809,W,0.299,,260120,,,A*72

GPGSA

$GPGSA,Smode,FS{,sv},PDOP,HDOP,VDOP*cs<CR><LF>

$GPGSA,A,3,23,29,07,08,09,18,26,28,,,,,1.94,1.18,1.54*0D

0 | 1 | 2 | 3 | 4 | 5 | 6 | 7 | 8 | 9 | 10
$GPGSA, | Smode, | Fix, | Sat1, | Sat2, | Sat3, | Sat4, | Sat5, | Sat6, | Sat7, | Sat8
$GPRMC, | A, | 3, | 23, | 29, | 07, | 08, | 09, | 18, | 26, | 28,
7 | 2 | 2 | 3 | 3 | 3 | 3 | 3 | 3 | 3 | 3

11 | 12 | 13 | 14 | 15 | 16 | 17 | 18 | 19
Sat9, | Sat10 | Sat11, | Sat12, | PDOP, | HDOP, | VDOP | *Check | CR LF
18, | 18, | 18, | 18, | 1.94, | 1.18, | 1.54 | *0D | 0xD 0xA
3 | 3 | 3 | 3 | 5 | 5 | 5 | 3 | 2

Tamanho = 67 bytes, vou usar tamanho 100.

Lido com Arduino: $GPGSA,A,3,07,09,16,23,04,01,,,,,,,8.16,1.24,8.06*09
