rzele/TCC-Caixa-Preta/docs/dispositivo/Serial.docx

Biblioteca Serial (Porta 0) para o Arduino

24/04/2020, Versão 1.0

Não usar classe “Serial.xxx”, pois é usada a interrupção de recepção da porta serial 0.

Senão surge o erro: multiple definition of `__vector_25'

Funções para a Serial 0

void | ser_dump_memo | (long adr, byte *vet) | Não
void | ser_gps_dados_lin | (char *gps_vt) | Não
void | ser_gps_dados | (char *gps_vt) | Não
void | ser_lin_ac_tp_gi | (byte *vet) | Não
void | ser_lin_ac_gi | (byte *vet) | Não
void | ser_lin_ac_gi_mg | (byte *vet) | Não
void | ser_ac_gi_mg | (byte *vet) | Não
void | ser_float | (float fx, byte prec) | Não
void | ser_dec32 | (long dt) | Não
void | ser_dec32u | (long dt) | Não
void | ser_dec32nz | (long dt) | Não
void | ser_dec32unz | (long dt) | Não
void | ser_hex32 | (long dt) | Não
void | ser_dec16 | (int dt) | Não
void | ser_dec16u | (word dt) | Não
void | ser_dec16nz | (int dt) | Não
void | ser_dec16unz | (word dt) | Não
void | ser_hex16 | (word dt) | Não
void | ser_dec8 | (byte dt) | Não
void | ser_dec8u | (byte dt) | Não
void | ser_dec8nz | (byte dt) | Não
void | ser_dec8unz | (byte dt) | Não
void | ser_hex8 | (byte dt) | Não
void | ser_crlf | (byte qtd) | Não
void | ser_cr | (byte qtd) | Não
void | ser_lf | (byte qtd) | Não
void | ser_spc | (byte qtd) | Não
void | ser_str | (byte *msg) | Não
void | ser_char | (byte dt) | Não
void | serb_float | (float fx, byte prec) | Sim
void | serb_dec32 | (long dt) | Sim
void | serb_dec32u | (long dt) | Sim
void | serb_dec32nz | (long dt) | Sim
void | serb_dec32unz | (long dt) | Sim
void | serb_hex32 | (long dt) | Sim
void | serb_dec16 | (int dt) | Sim
void | serb_dec16u | (word dt) | Sim
void | serb_dec16nz | (int dt) | Sim
void | serb_dec16unz | (word dt) | Sim
void | serb_hex16 | (word dt) | Sim
void | serb_dec8 | (byte dt) | Sim
void | serb_dec8u | (byte dt) | Sim
void | serb_dec8nz | (byte dt) | Sim
void | serb_dec8unz | (byte dt) | Sim
void | serb_hex8 | (byte dt) | Sim
void | serb_crlf | (byte qtd) | Sim
void | serb_cr | (byte qtd) | Sim
void | serb_lf | (byte qtd) | Sim
void | serb_spc | (byte qtd) | Sim
void | serb_str | (byte *msg) | Sim
void | serb_char | (byte dt) | Sim
void | serb_esvazia_tx | (void) | Sim
void | ser_tx_fila_config | (void)
char | ser_tx_poe | (char dt)
char | ser_tx_tira | (char *dt)
void | ser_config | (long br)
void | ser_rx_fila_config | (void)
char | ser_rx_poe | (char dt)
char | ser_rx_tira | (char *dt)

- void ser_dump_memo (long adr, byte *vet)

Auxilia na impressão para o DUMP de memórias. Gera linhas do tipo abaixo

0000 0000: F8 A4 32 EB 69 6E 6F 20 65 78 70 6C 6F 72 65 72 - ⸮⸮2⸮ino explorer

0000 0010: 20 73 74 6B 35 30 30 56 32 20 62 79 20 4D 4C 53 - stk500V2 by MLS

0000 0020: 00 42 6F 6F 74 6C 6F 61 64 65 72 3E 00 48 75 68 - .Bootloader>.Huh

- void ser_gps_dados_lin (char *gps_vt)

Imprimir os dados GPS do vetor (pacote gps_dados) em uma linha só. Segue a ordem abaixo.

Lembrar que Status = V indica que não achou os satélites.

Status – data – hora – LatNS – LONGEW – vel km/h – vel nós – curso – altitude – [qtd sat – PDOP – HDOP – VDOP] – adr SRAM

- void ser_gps_dados (char *gps_vt)

Imprimir GPS, todos os dados no pacote gps_dados.

- void ser_lin_ac_tp_gi (byte *vet)

Montar as palavras de 16 bits e imprimir uma linha com acel, temp e giro.

Recebe vetor com bytes e monta words para imprimir.

- void ser_lin_ac_gi (byte *vet){

Montar as palavras de 16 bits e imprimir uma linha com acel e giro.

Recebe vetor com bytes e monta words para imprimir.

- void ser_lin_ac_gi_mg (byte *vet)

Compor e imprimir uma linha com aceleração, giroscópio e magnetômetro

- void ser_ac_gi_mg (byte *vet)

Compor aceleração, giroscópio e magnetômetro. Imprime 1 por linha

- void ser_float (float f, byte prec)

No Arduino, double e float têm a mesma precisão

Escreve no LCD o float fx com prec casas após a vírgula e apresenta o sinal.

Formato = + xxx xxx xxx , ddd ddd ddd ddd (usar char msg[24])

Limite da parte inteira = 9 dígitos. Limite da parte fracionária = 12 dígitos.

Caso ultrapasse esses os limites imprime ###, ###

O máximo é 999.999.999,999999. Se ultrapassar o máximo, escreve ###,###.

Na verdade, o máximo é 999.999.999,999967. Exemplos:

999.999.999,0 → imprime 999.999.936,000000 (por causa da precisão da representação)

876.543.210,123456789 → imprime 876543232,000000 (por causa da precisão da representação)

- void ser_dec32 (long dt)

Escrever no LCD 32 bits em decimal, com sinal e com zeros à esquerda.

- void ser_dec32u (long dt)

Escrever na fila serial32 bits em decimal, sem sinal e com zeros à esquerda.

- void ser_dec32nz (long dt)

Escrever na fila serial32 bits em decimal, com sinal e sem zeros à esquerda.

- void ser_dec32unz (long dt)

Escrever na fila serial 32 bits em decimal, sem sinal e sem zeros à esquerda.

- void ser_hex32 (long dt)

Escrever na fila serial 32 bits em hexadecimal.

- void ser_dec16 (word dt)

Escrever na fila serial 16 bits em decimal, com sinal e com zeros à esquerda.

- void ser_dec16u (word dt)

Escrever na fila serial 16 bits em decimal, sem sinal e com zeros à esquerda.

- void ser_dec16nz (word dt)

Escrever na fila serial 16 bits em decimal, com sinal e sem zeros à esquerda.

- void ser_dec16unz (word dt)

Escrever na fila serial 16 bits em decimal, sem sinal e sem zeros à esquerda.

- void ser_hex16 (word dt)

Escrever na fila serial 16 bits em hexadecimal.

- void ser_dec8 (byte dt)

Escrever na fila serial 8 bits em decimal, com sinal e com zeros à esquerda.

- void ser_dec8u (byte dt)

Escrever na fila serial 8 bits em decimal, sem sinal e com zeros à esquerda.

- void ser_dec8nz (byte dt)

Escrever na fila serial 8 bits em decimal, com sinal e sem zeros à esquerda.

- void ser_dec8unz (byte dt)

Escrever na fila serial 8 bits em decimal, sem sinal e sem zeros à esquerda.

- void ser_hex8 (byte dt)

Escrever na fila serial 8 bits em hexadecimal.

- void ser_crlf (byte qtd)

Colocar na fila qtd de pares CR (0xD = ‘\r’) e LF (0xA = ‘\n’.

- void ser_cr (byte qtd)

Colocar na fila qtd Carriage Return (CR = 0xD = ‘\r’).

- void ser_lf (byte qtd)

Colocar na fila qtd Line Feed (LF = 0xA = ‘\n’).

- void ser_spc (byte qtd)

Colocar na fila qtd brancos (0x20).

- void ser_str (byte *msg)

Colocar a string apontada por msg no buffer serial.

- void ser_char (byte dt)

Colocar um char no buffer serial. Gera alerta no LCD se fila serial encher.

- void ser_esvazia_tx (void)

Esvazia toda a fila de transmissão serial. Fica preso até enviar tudo.

- void ser_tx_fila_config (void)

Inicializar fila de transmissão serial.

- char ser_tx_poe (char cha)

Colocar um byte na fila de transmissão. Retorna TRUE se conseguiu. Retorna FALSE se fila cheia.

Se fila encher, chama a função ser_fila_tx_cheia() para imprimir msg de erro na serial.

- void ser_fila_tx_cheia (void)

Imprime mensagem de erro na porta serial para indicar que a fila serial TX está cheia.

- char ser_tx_tira (char *cha)

Coloca no ponteiro *char o byte retirado da fila de transmissão e retorna TRUE.

Se retornar FALSE é porque a fila está vazia.

- void ser_rx_fila_config (void)

Inicializar fila de recepção serial.

- char ser_rx_poe (char cha)

Colocar um byte na fila de recepção. Retorna TRUE se conseguiu. Retorna FALSE se fila cheia.

Se fila encher, chama a função ser_fila_rx_cheia() para imprimir msg de erro na serial.

- void ser_fila_rx_cheia (void)

Imprime mensagem de erro na porta serial para indicar que a fila serial RX está cheia.

- char ser_rx_tira (char *cha)

Coloca no ponteiro *char o byte retirado da fila de recepção e retorna TRUE.

Se retornar FALSE é porque a fila está vazia.

- void ser_config (long br)

Configurar porta serial com o baud rate = BR. Habilitar interrupção por transmissão e recepção.

- ISR (USART0_TX_vect)

ISR: Interrupção por dado enviado, faz ser_tx_ok=TRUE para indicar que transmitiu um dado.

- ISR (USART0_RX_vect)

ISR: Interrupção por dado recebido, faz ser_rx_ok=TRUE para indicar que recebeu um dado.

Gabarito dos registradores de configuração da porta serial USART0

| 7 | 6 | 5 | 4 | 3 | 2 | 1 | 0
UCSR0A | RXC0 | TXC0 | UDRE0 | FE0 | DOR0 | UPE0 | U2X0 | MPCM0
| 0 | 0 | 0 | 0 | 0 | 0 | 1 | 0
UCSR0B | RXCIE0 | TXCIE0 | UDRIE0 | RXEN0 | TXEN0 | UCSZ02 | RXB80 | TXB80
| 0 | 1 | 0 | 1 | 1 | 0 | 0 | 0
UCSR0C | UMSEL01 | UMSEL00 | UPM01 | UPM00 | USBS0 | UCSZ01 | UCSZ00 | UCPOL0
| 0 | 0 | 0 | 0 | 0 | 1 | 1 | 0

Tabela 8.11. Exemplos de Baud Rate para o Arduino Mega (16 MHz)

Baud Rate

(bps)
| U2Xn = 1
| UBRR | Erro
9.600 | 207 | 0,2%
19.200 | 103 | 0,2%
38.400 | 51 | 0,2%
57.600 | 34 | -0,8%
115.200 | 16 | 2,1%
230.400 | 8 | -3,5%
250.000 | 7 | 0%

Filas circulares para transmissão e para recepção

Fila TX

volatile char ser_tx_fila [SER_TX_FILA_TAM]; //Espaço para a fila serial

volatile byte ser_tx_pin, ser_tx_pout; //Ponteiros para usar a fila

volatile byte ser_tx_ok; //Indica que terminou transmissão

volatile char ser_rx_fila[SER_RX_FILA_TAM]; //Espaço para a fila serial de RX

volatile byte ser_rx_pin, ser_rx_pout; //Ponteiros para usar a fila

volatile byte ser_rx_ok; //Indica que terminou recepção
