rzele/TCC-Caixa-Preta/docs/dispositivo/TWI.docx

Biblioteca para o TWI (I2C)

Funções

byte | twi_er_ok | (byte adr)
void | twi_scan | (void)
void | twi_config_400k | (void)
void | twi_config_100k | (void)
void | void twi_start | (byte ix)
void | void twi_start_rep | (int ix)
void | twi_stop | (void)
byte | twi_er_check | (byte ee, byte ix)
void | twi_er | (byte eer, byte ix)
void | twi_et | (byte eet, byte ix)
void | twi_dado_er | (byte dado, byte ix)
byte | twi_dado_et_ack | (byte ix)
byte | byte twi_dado_et_nack | (byte ix)
byte | byte espera_twint | (byte ix)
void | twi_erro | (int cod, int ix)

- byte twi_er_ok (byte adr)

Verificar se tem resposta do escravo receptor no endereço “adr”.

TRUE se escravo respondeu com ACK.

FALSE se escravo respondeu com NACK.

- void twi_scan (void)

Buscar por todos os dispositivos TWI para escrita. Imprime na serial o que encontrar.

Como busca por escrita, faz adr<<1 = bbbb bbb0.

- void twi_config_400k (void)

Configurar TWI para 400k (frequência da linha SCL).

- void twi_config_100k (void)

Configurar TWI para 100k (frequência da linha SCL).

- void twi_start (byte ix)

Gerar um START no TWI.

- void twi_start_rep (int ix)

Gerar um START Repetido no TWI.

- void twi_stop (void)

Enviar STOP.

- byte twi_er_check (byte ee, byte ix)

Enviar endereço de Escrita do Escravo Receptor (ER) e esperar ACK.

Retorna TRUE se escravo gerou ACK.

Retorna FALSE se gerou NACK (não gera msg de erro).

ee = endereço do escravo.

- void twi_er (byte eer, byte ix)

Enviar endereço de Escrita do Escravo (ER) e esperar ACK.

eer = endereço do escravo receptor.

- void twi_et (byte eet, byte ix)

Enviar endereço de Leitura do Escravo (ET) e esperar ACK.

eet = endereço do escravo transmissor.

- void twi_dado_er (byte dado, byte ix)

Enviar dado para escravo previamente endereçado.

- byte twi_dado_et_ack (byte ix)

Receber dado e gerar ACK.

- byte twi_dado_et_nack (byte ix)

Receber dado e gerar NACK.

- byte espera_twint (byte ix)

Esperar TWINT.

- void twi_erro (int cod, int ix)

ERROS no TWI (I2C).

1 = Erro ao gerar START.

2 = Erro ao gerar START Repetido.

3 = Erro Escravo Receptor endereçado (ER) não enviou ACK.

4 = Erro Escravo Transmissor endereçado (ET) não enviou ACK.

5 = Erro Escravo Receptor (ER) não enviou ACK após envio do dado.

6 = Erro ao receber um dado do Escravo Transmissor (ET) e gerar um ACK.

7 = Erro ao receber um dado do Escravo Transmissor (ET) e gerar um NACK.

8 = Erro ao esperar TWINT - Timeout esperando TWINT ir para 1.

Gabarito para configurar os registradores do TWI

| 7 | 6 | 5 | 4 | 3 | 2 | 1 | 0
TWCR | TWINT | TWEA | TWSTA | TWSTO | TWWC | TWEN | - | TWIE
| 0 | 0 | 0 | 0 | 0 | 0 | | 0
TWSR | TWS7 | TWS6 | TWS5 | TWS4 | TWS3 | - | TWPS1 | TWPS0
| 0 | 0 | 0 | 0 | 0 | 0 | 0 | 0
TWBR | TWBR7 | TWBR6 | TWBR5 | TWBR4 | TWBR3 | TWBR2 | TWBR1 | TWBR0
TWDR | TWD7 | TWD6 | TWD5 | TWD4 | TWD3 | TWD2 | TWD1 | TWD0
TWAR | TWA6 | TWA5 | TWA4 | TWA3 | TWA2 | TWA1 | TWA0 | TWGCE
TWAMR | TWAM6 | TWAM5 | TWAM4 | TWAM3 | TWAM2 | TWAM1 | TWAM0 | -

Frequência SCL=(Frequência do relógio da CPU)/(16+2∙(TWBR)∙4^(TWPS))

TWBR=((Frequência do relógio da CPU)/(Frequência SCL)-16)/(2∙4^(TWPS))
