rzele/TCC-Caixa-Preta/schemas/CXP 1p3/CAIXA PRETA 1p3-final.pdf

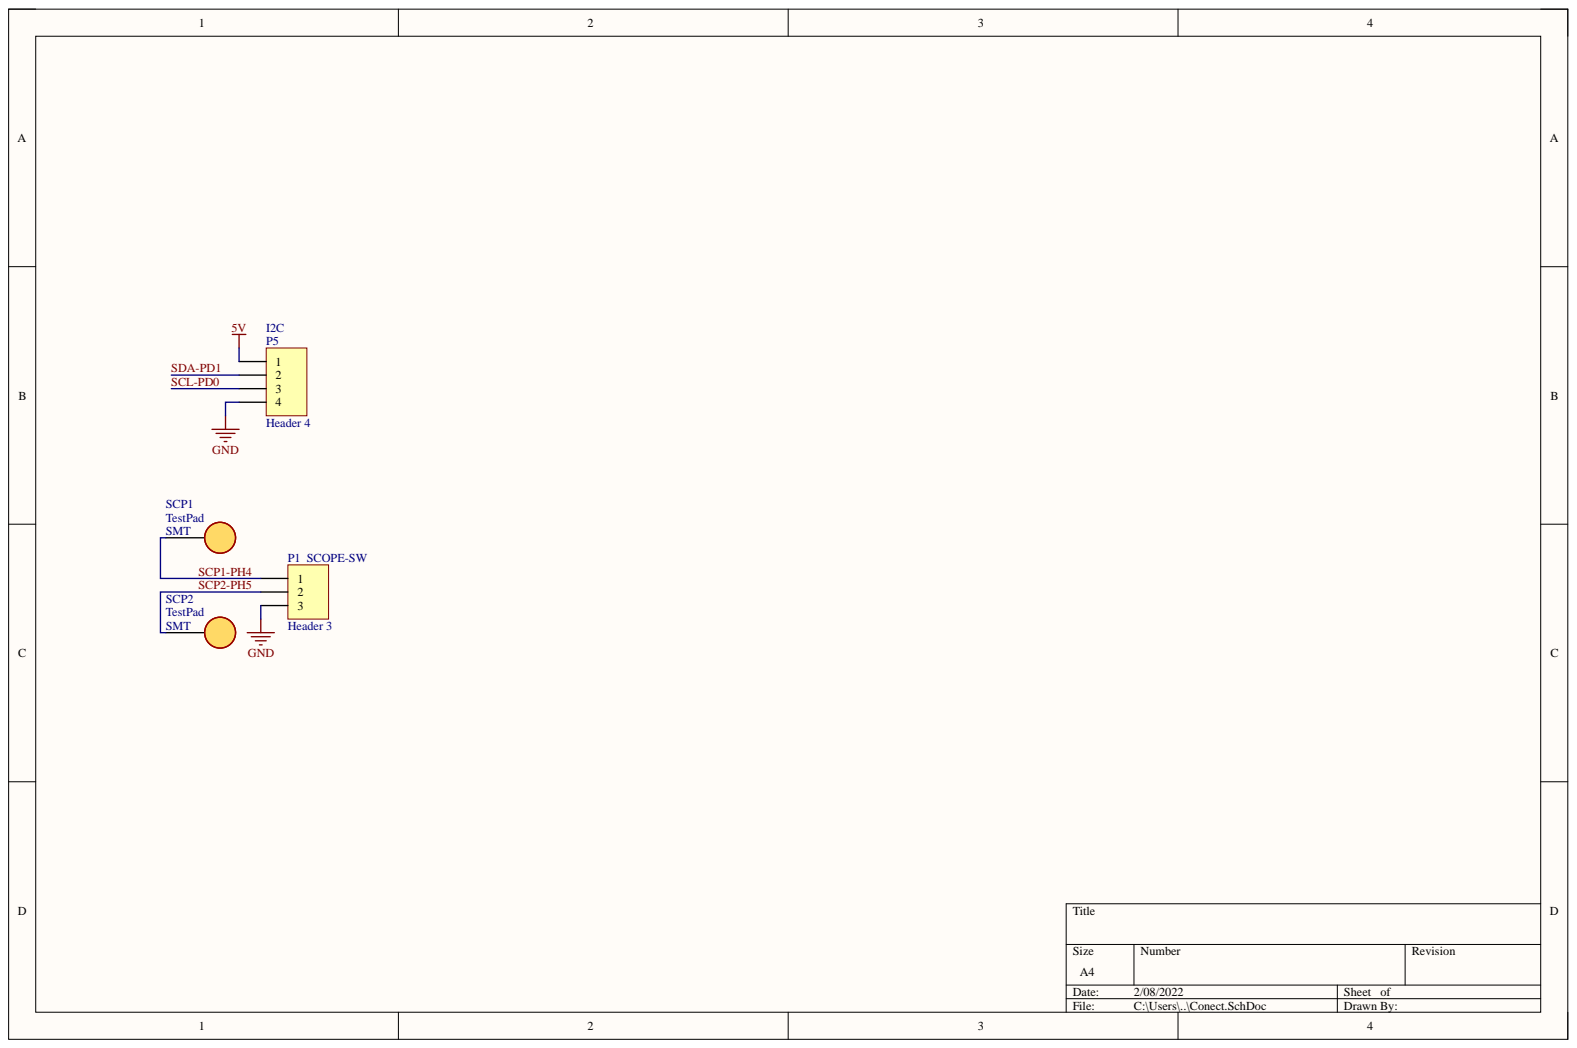
[picture p13: page 1]

Size A4 | Number | Revision

Date: 2/08/2022 | Sheet of
File: C:\Users\..\Conect.SchDoc | Drawn By:

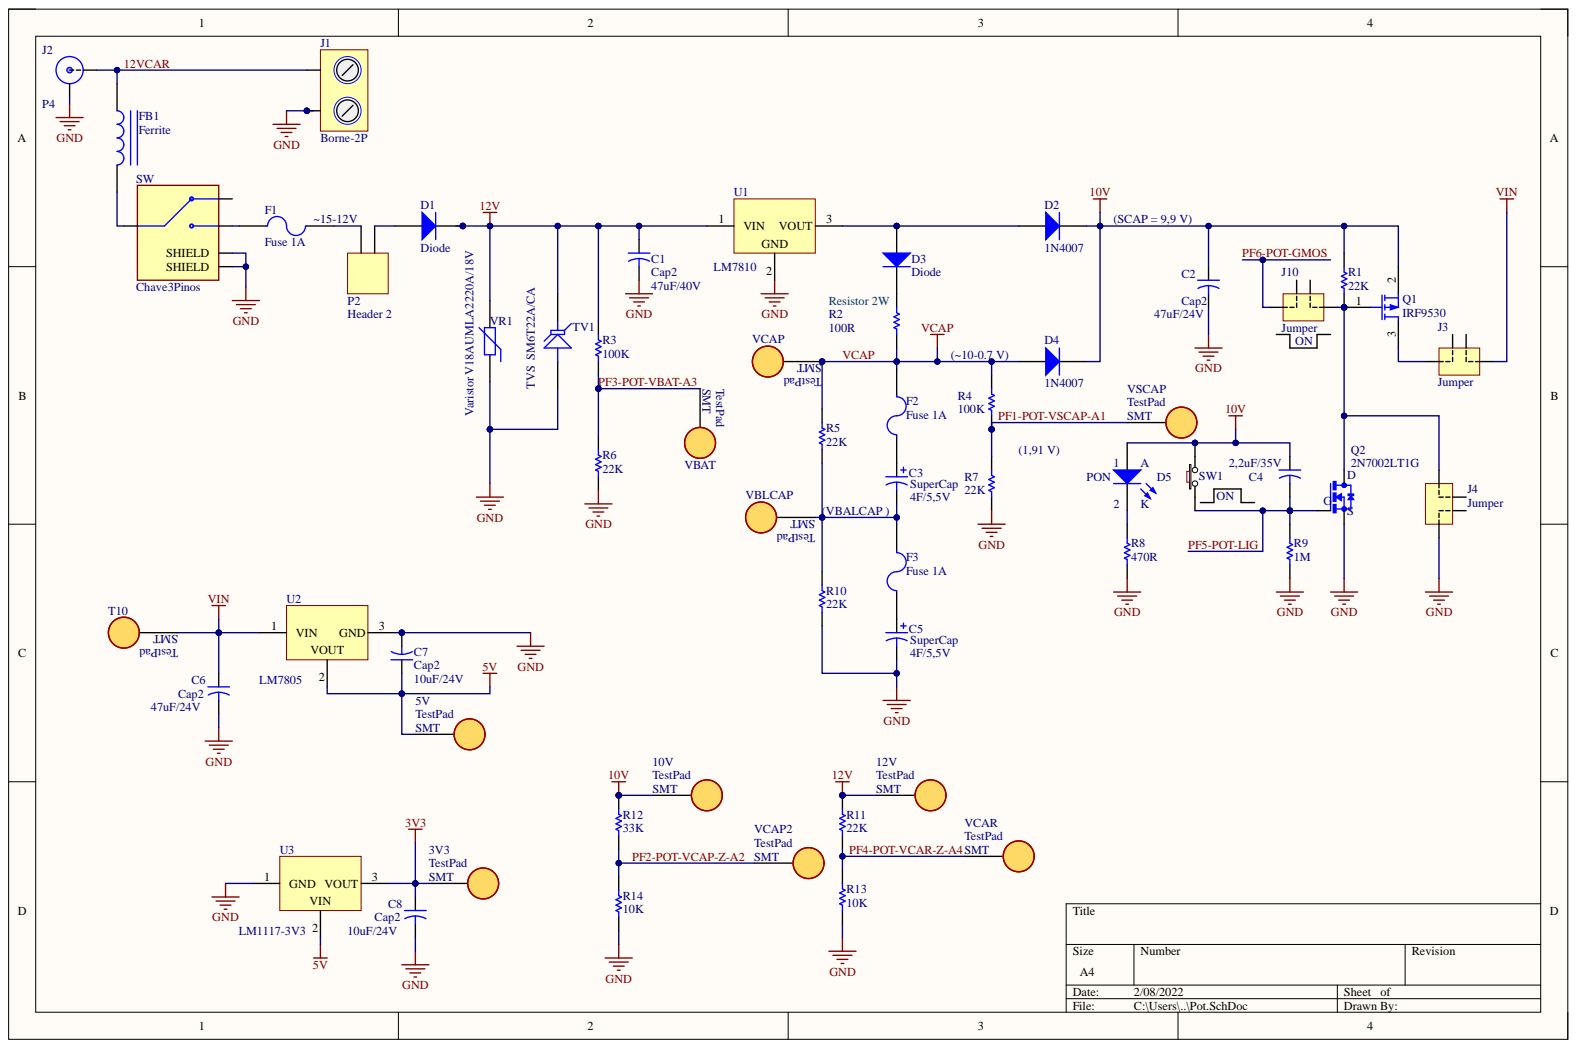
[picture p14: page 2]

Size A4 | Number | Revision

Date: 2/08/2022 | Sheet of
File: C:\Users\..\Pot.SchDoc | Drawn By:

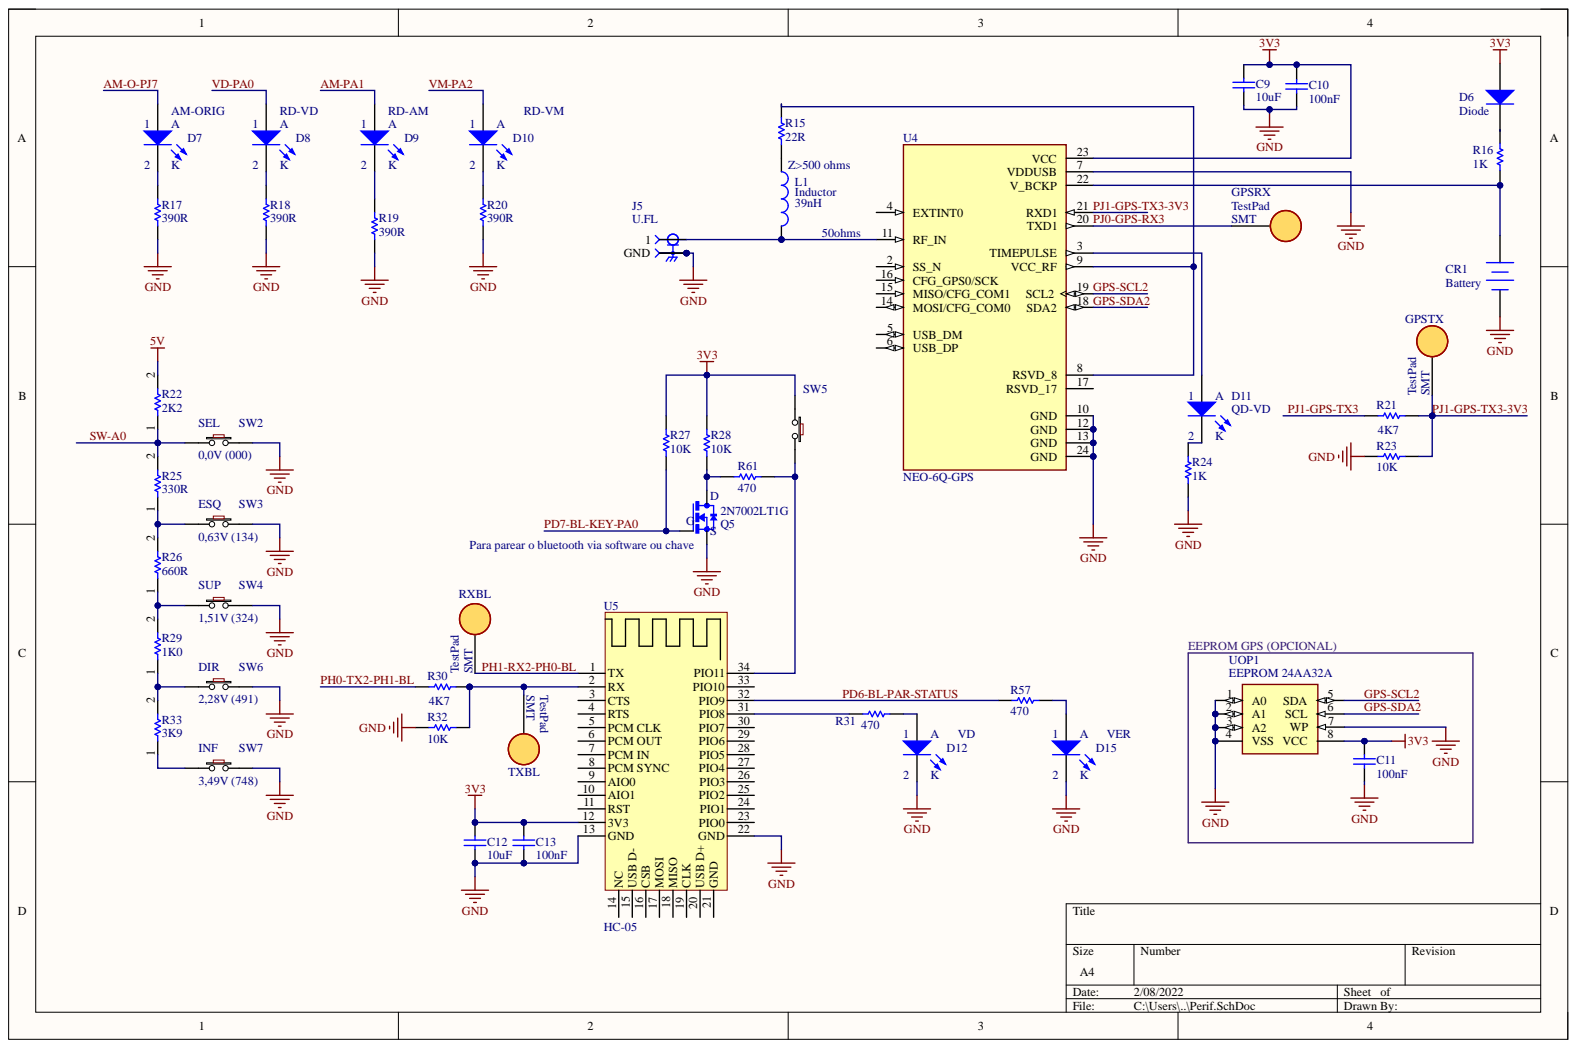
[picture p15: page 3]

Para parear o bluetooth via software ou chave

Size A4 | Number | Revision

Date: 2/08/2022 | Sheet of
File: C:\Users\..\Perif.SchDoc | Drawn By:

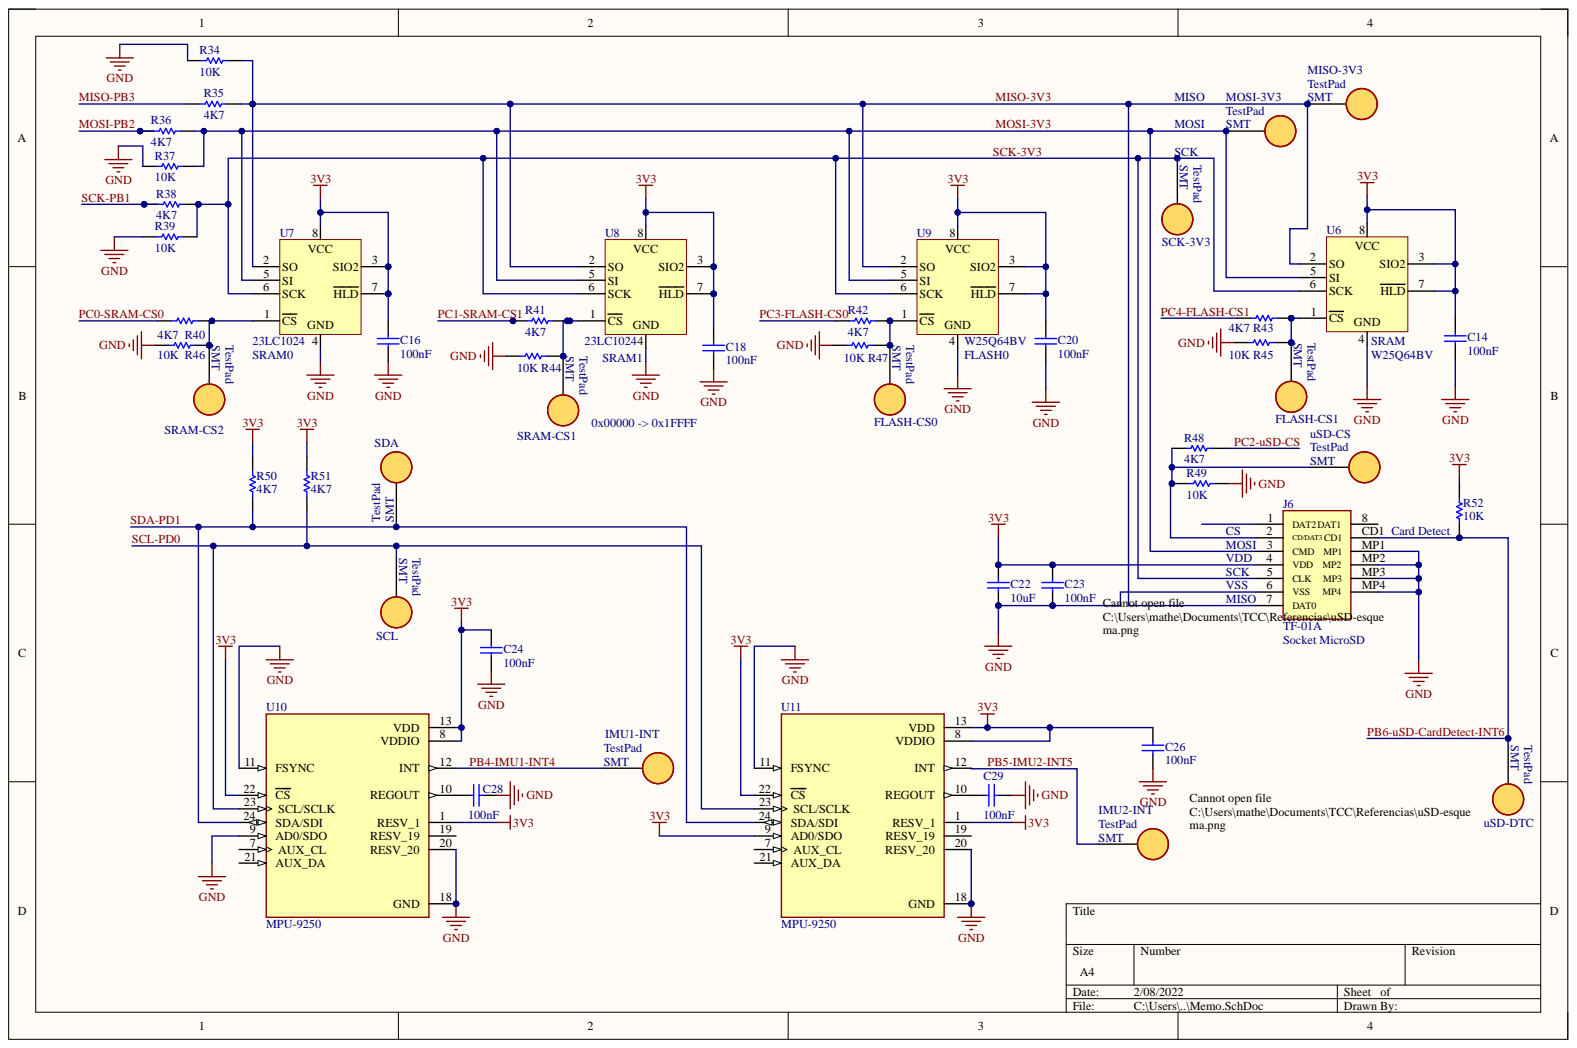
[picture p16: page 4]

SCL-PD0

Cannot open file
C:\Users\mathe\Documents\TCC\Referencias\uSD-esque
ma.png

Size A4 | Number | Revision

Date: 2/08/2022 | Sheet of
File: C:\Users\..\Memo.SchDoc | Drawn By:

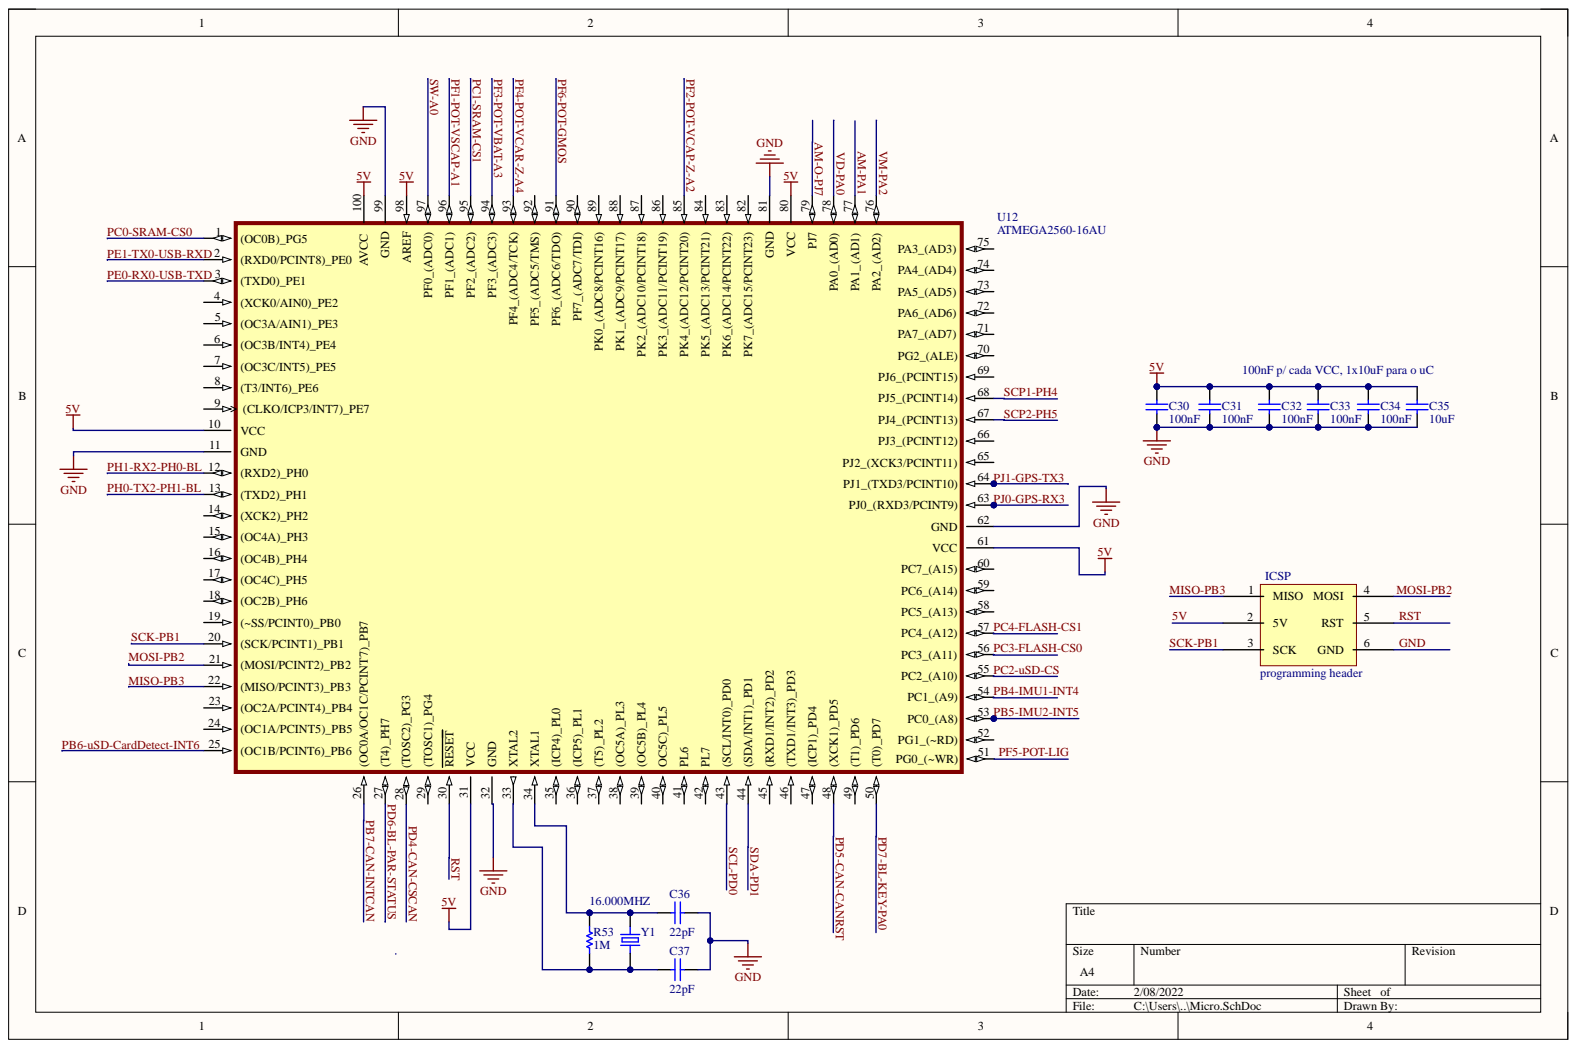
[picture p17: page 5]

PC4-FLASH-CS1 PC2-uSD-CS PC3-FLASH-CS0

Size A 4 | Numbe r | Revision

Date: 2/08/2022 C:\Users\..\Micro.SchDoc | Sheet of File: Drawn By

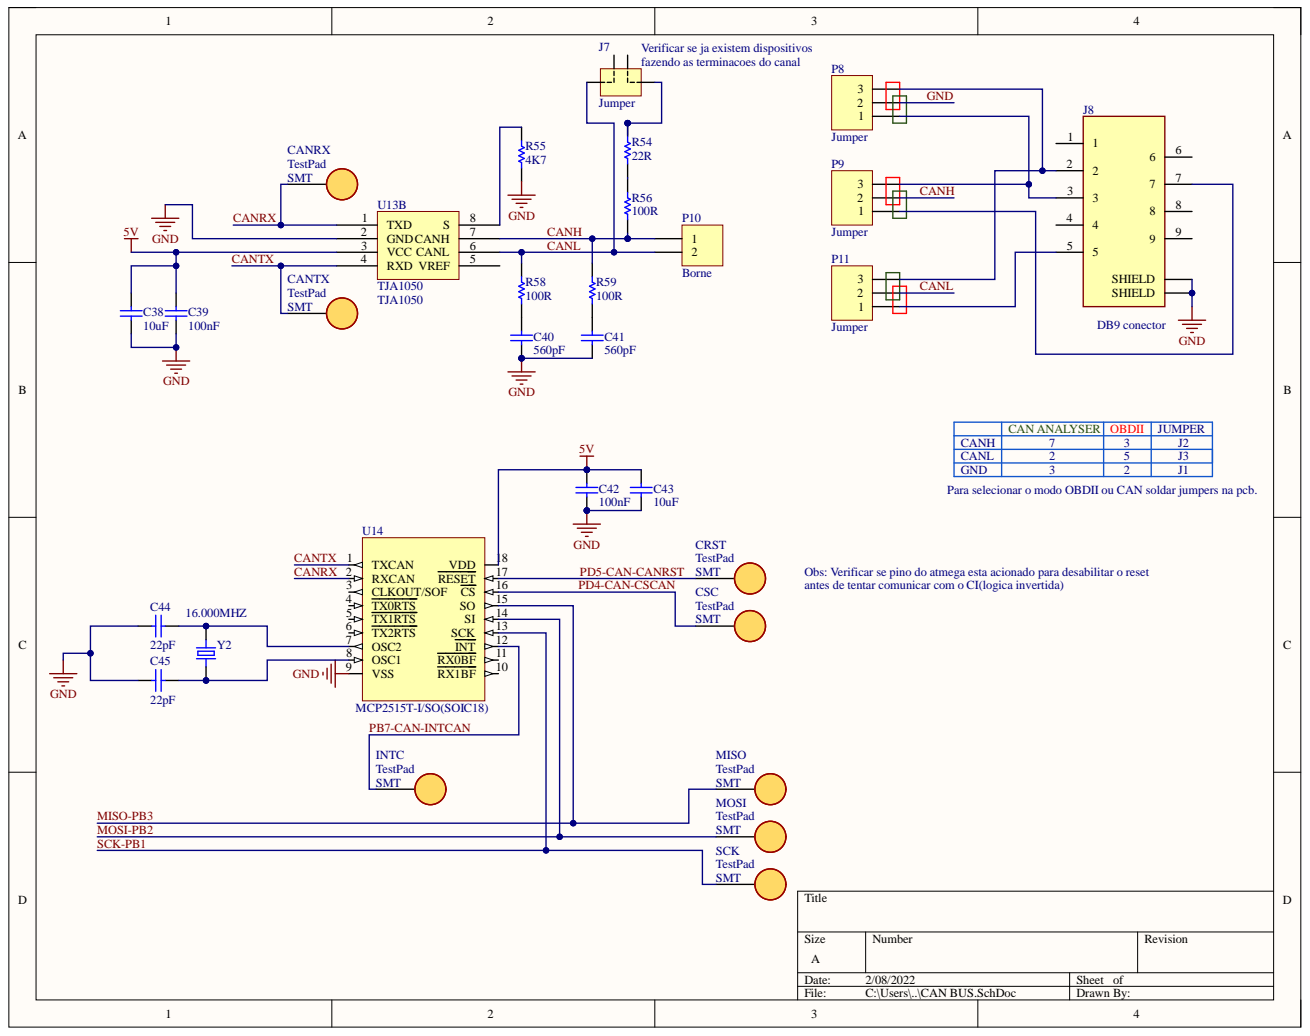
[picture p18: page 6]

Verificar se ja existem dispositivos
fazendo as terminacoes do canal

VCC 3 | CANL

CAN ANALYSER | OBDII | JUMPER

CANH | 7 | 3 | J2
CANL | 2 | 5 | J3
GND | 3 | 2 | J1

Para selecionar o modo OBDII ou CAN soldar jumpers na pcb.

Obs: Verificar se pino do atmega esta acionado para desabilitar o reset
antes de tentar comunicar com o CI(logica invertida)

TX1RTS 5 SI SCK INT RX0BF RX1BF | 14

13
12

OSC1 8 | 11 10

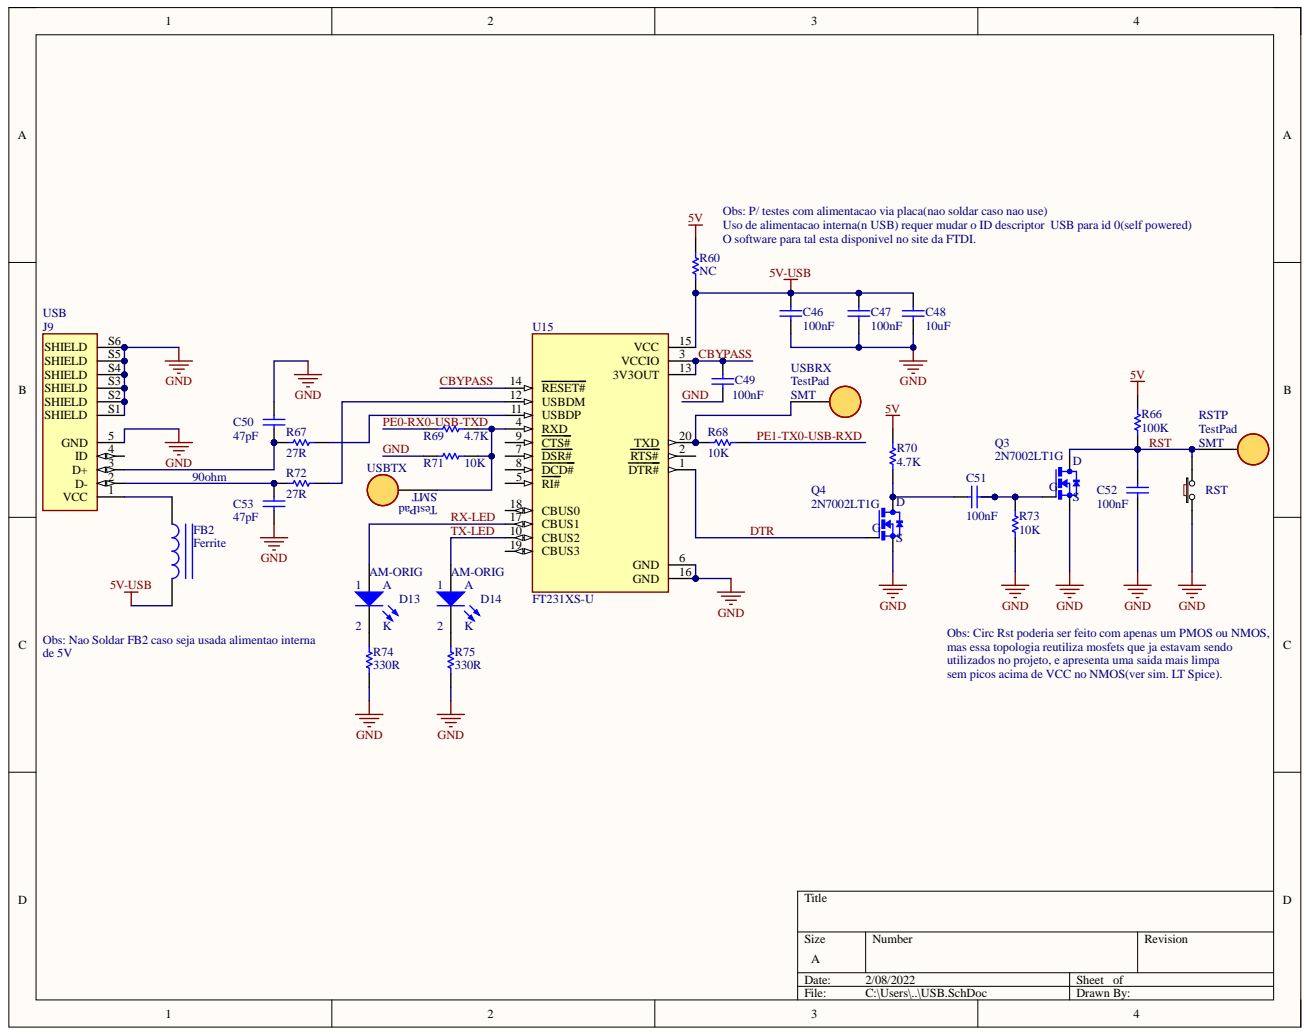
[picture p19: page 7]

P/ testes com alimentacao via placa(nao soldar caso nao use)
Uso de alimentacao interna(n USB) requer mudar o
O software para tal esta disponivel no site da

ID descriptor USB para id 0(self powered)

TX-LED

Obs: Circ Rst poderia ser feito com apenas um
mas essa topologia reutiliza mosfets que ja estavam sendo
utilizados no projeto, e apresenta uma saida mais limpa
sem picos acima de VCC no NMOS(ver sim.

FB2 caso seja usada alimentao interna

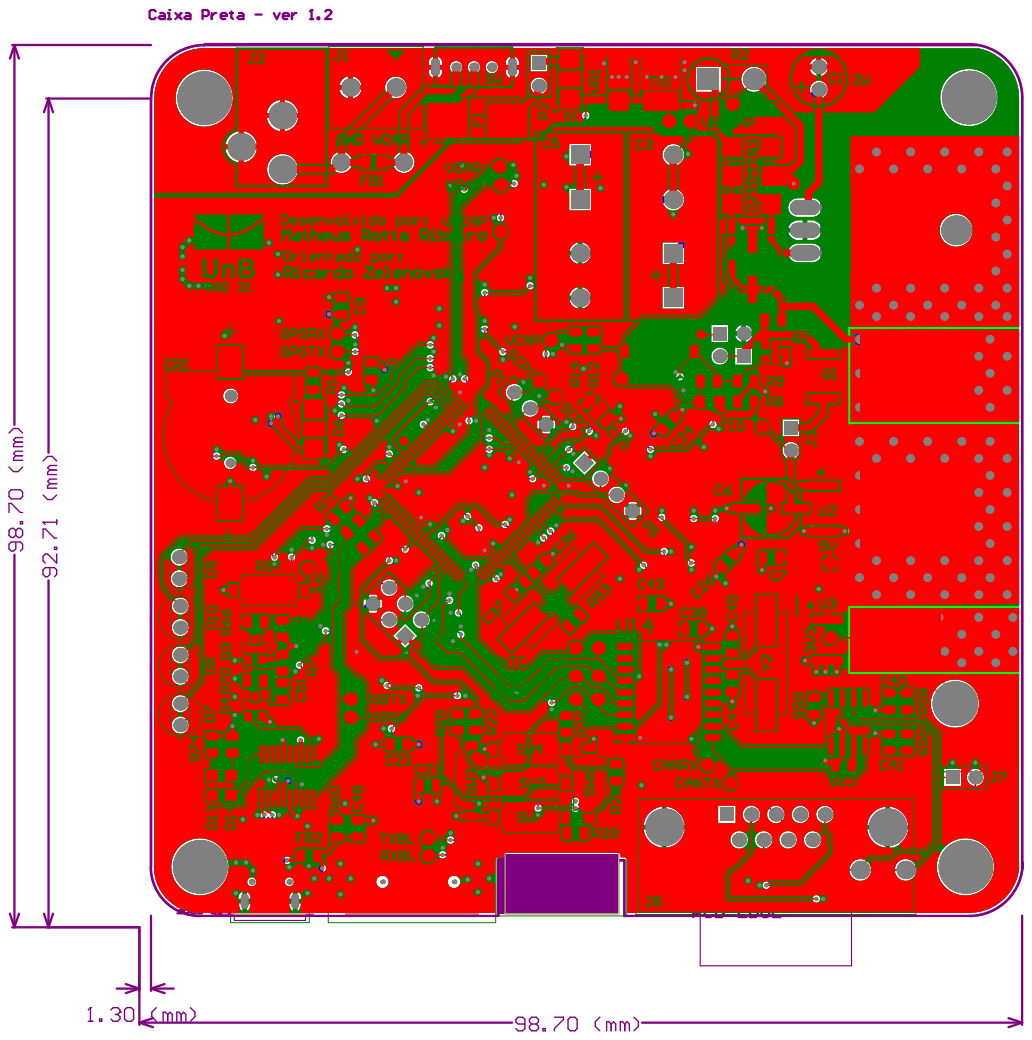
[picture p20: page 8]

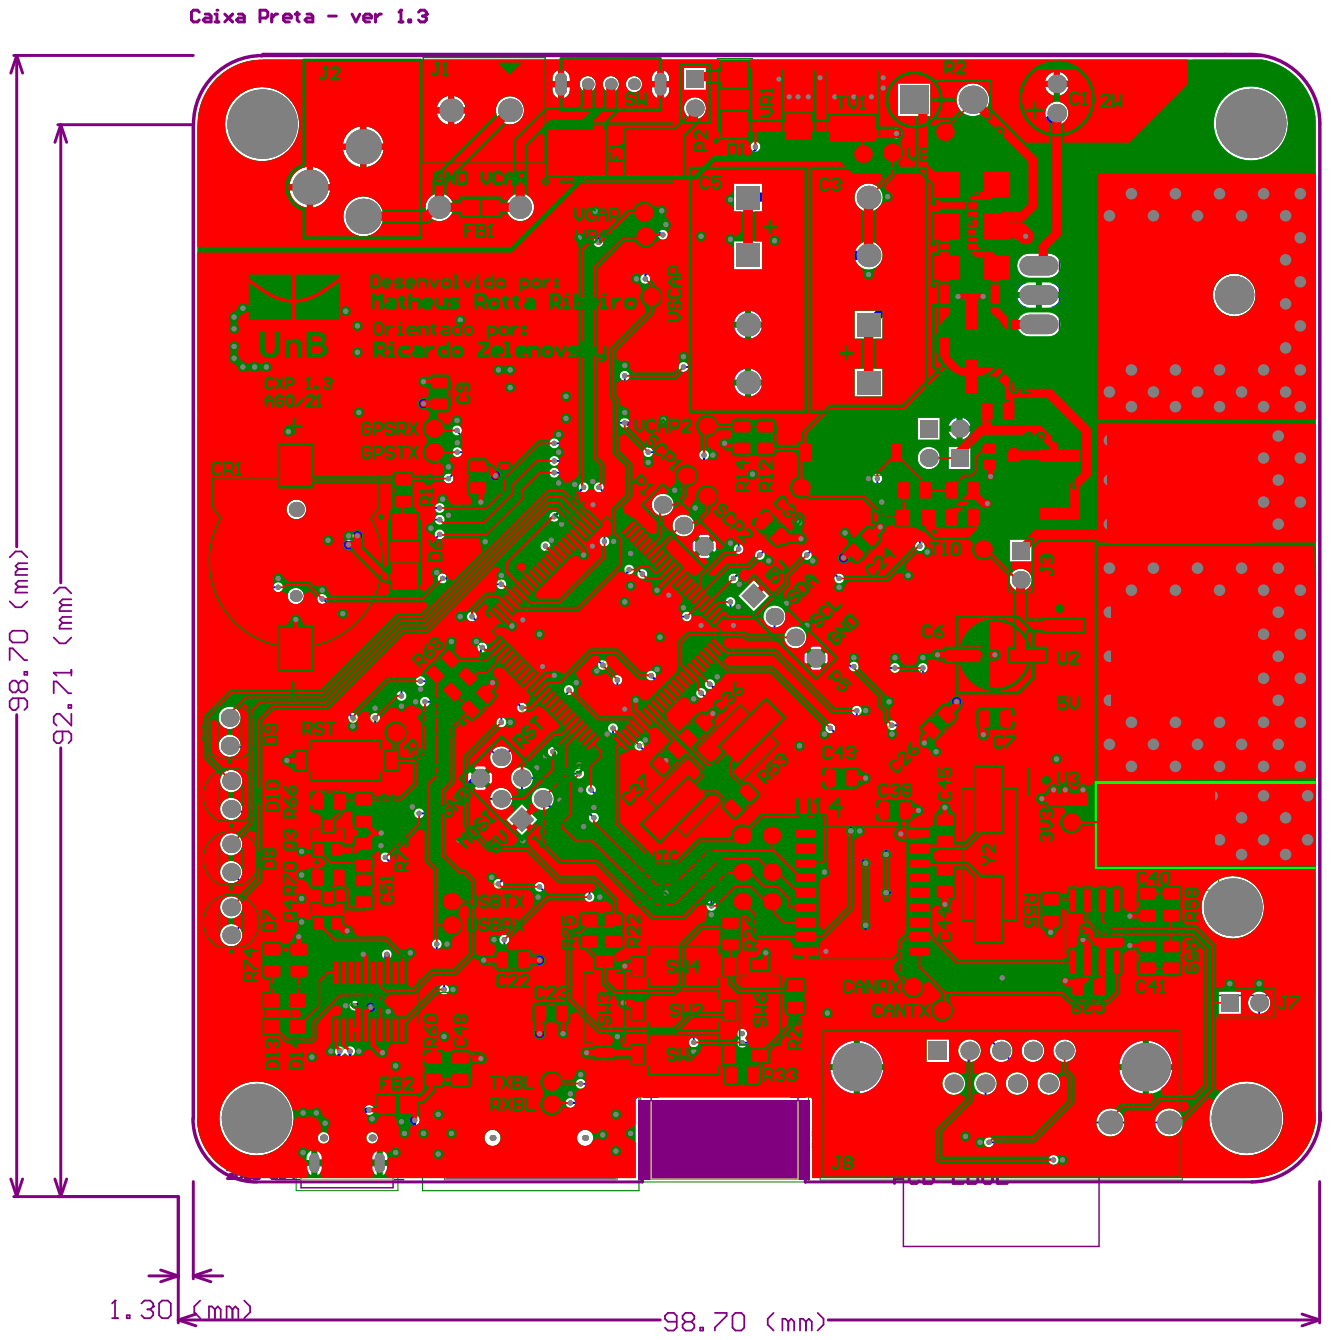
[picture p21: page 9]
