rzele/TCC-Caixa-Preta/schemas/CXP 1p3/Conect.pdf

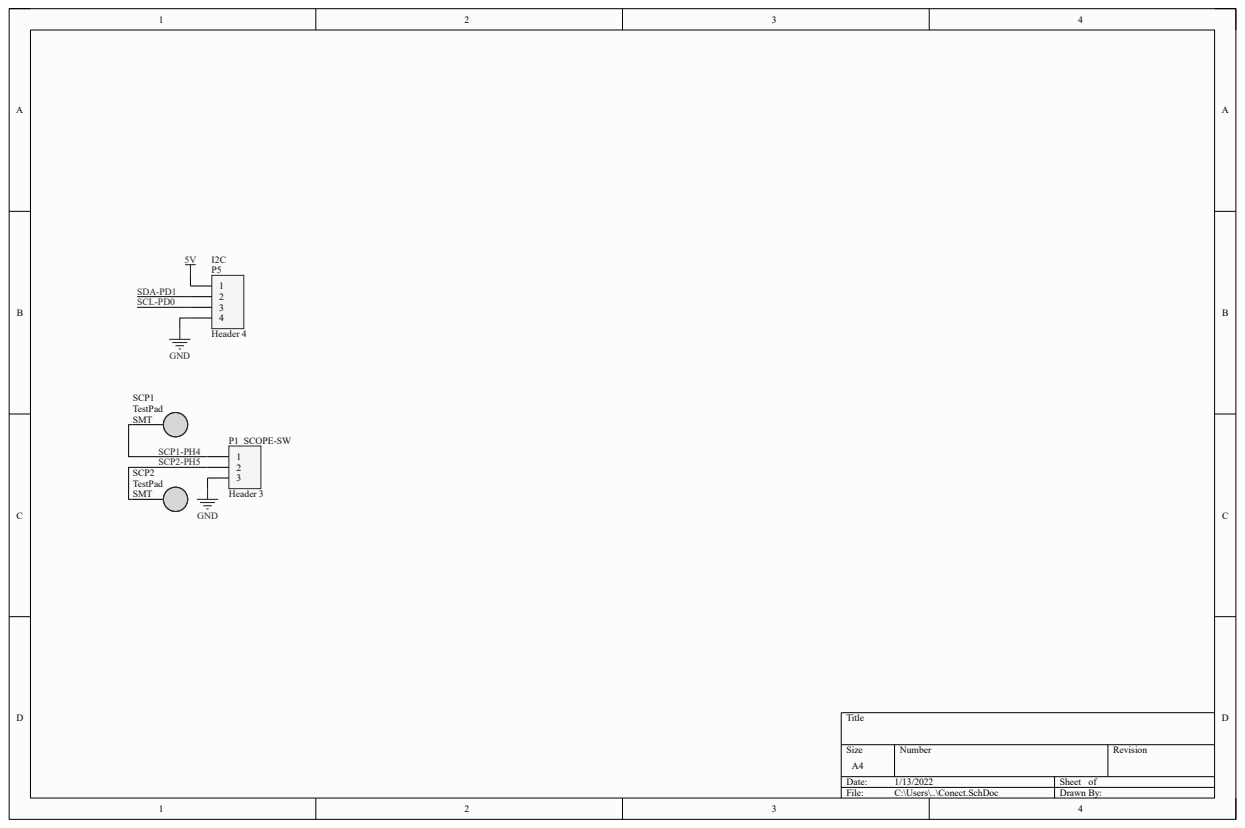
[picture p22: page 1]
Title; Size; Number; Revision; Date:; Sheet of; File:; C:\Users\..\Conect.SchDoc; Drawn By:; GND; SCOPE-SW; SCP1-PH4 SCP2-PH5; Header 4; SDA-PD1 SCL-PD0; Header 3; TestPad SMT; SCP1; SCP2
