rzele/TCC-Caixa-Preta/schemas/CXP 1p3/USB.pdf

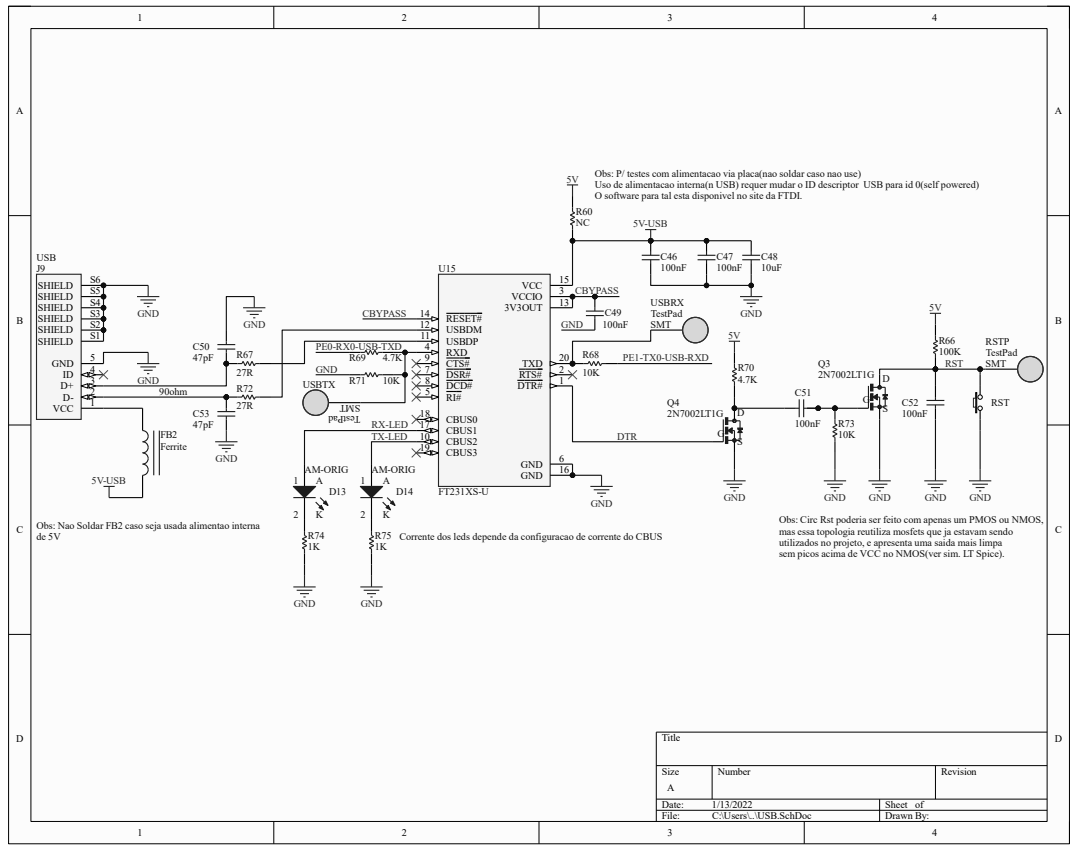
[picture p23: page 1]

Obs: P/ testes com alimentacao via placa(nao soldar caso nao use)
Uso de alimentacao interna(n USB) requer mudar o ID descriptor USB para id 0(self powered)
O software para tal esta disponivel no site da FTDI.

Obs: Circ Rst poderia ser feito com apenas um PMOS ou NMOS,
mas essa topologia reutiliza mosfets que ja estavam sendo
utilizados no projeto, e apresenta uma saida mais limpa
sem picos acima de VCC no NMOS(ver sim. LT Spice).

Obs: Nao Soldar FB2 caso seja usada alimentao interna

Corrente dos leds depende da configuracao de corrente do CBUS
