rzele/TCC-Caixa-Preta/peripherals/NEO-6M GPS Module — An Introduction.pdf

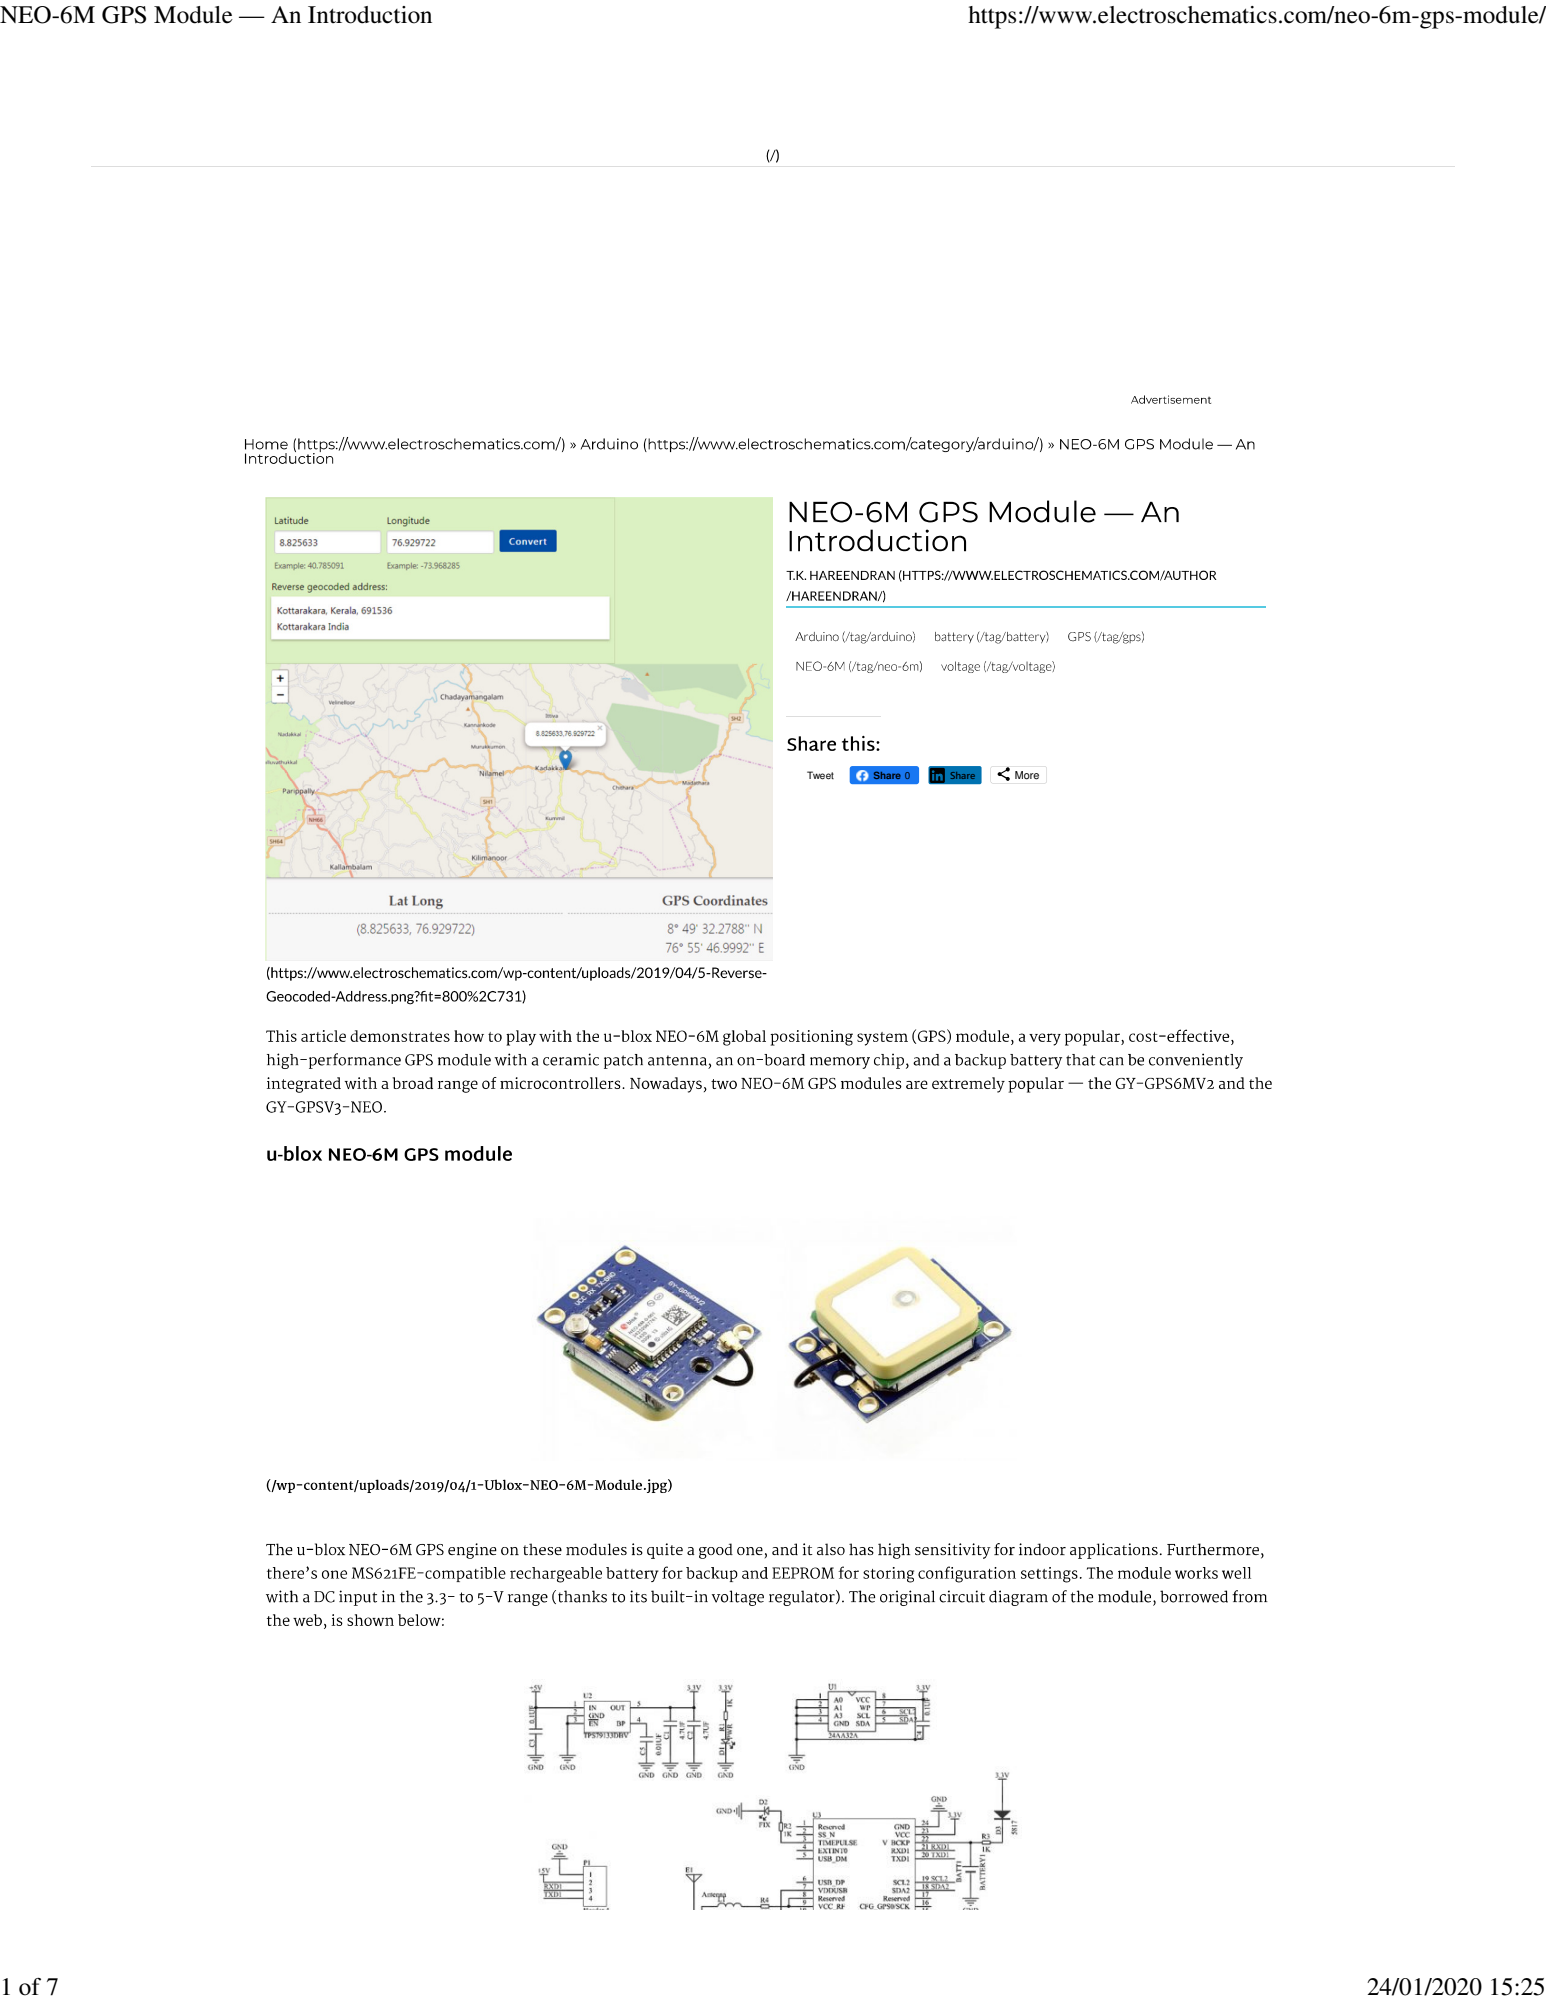
[picture p24: page 1]
Tweet; Share 0; Share; More; NEO-6M GPS Module — An Introduction; https://www.electroschematics.com/neo-6m-gps-module/

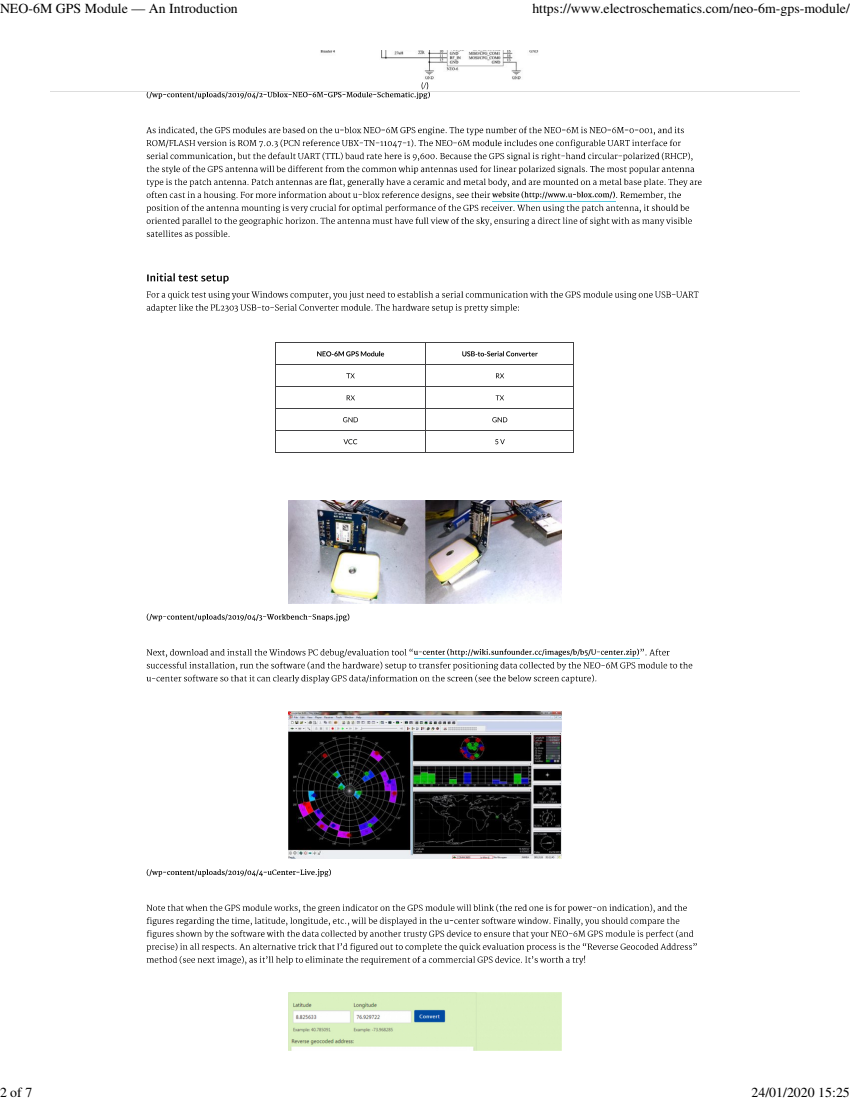
[picture p25: page 2]

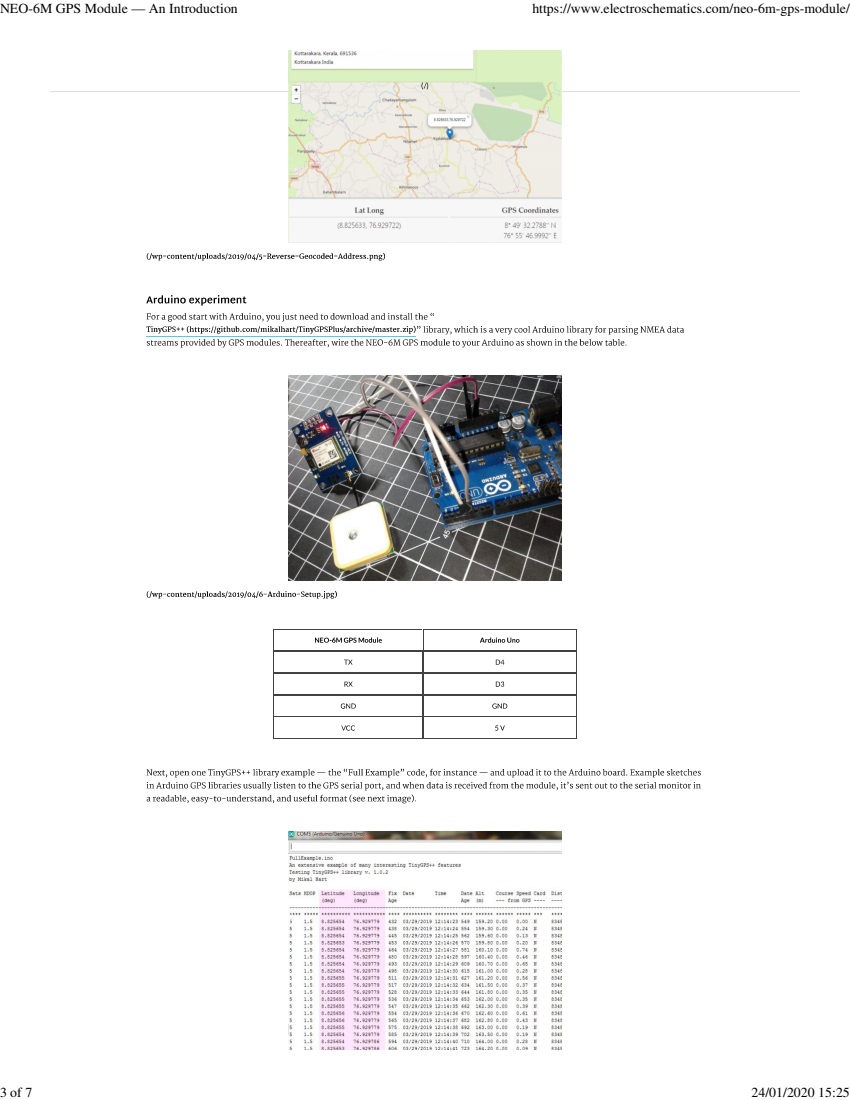
[picture p26: page 3]

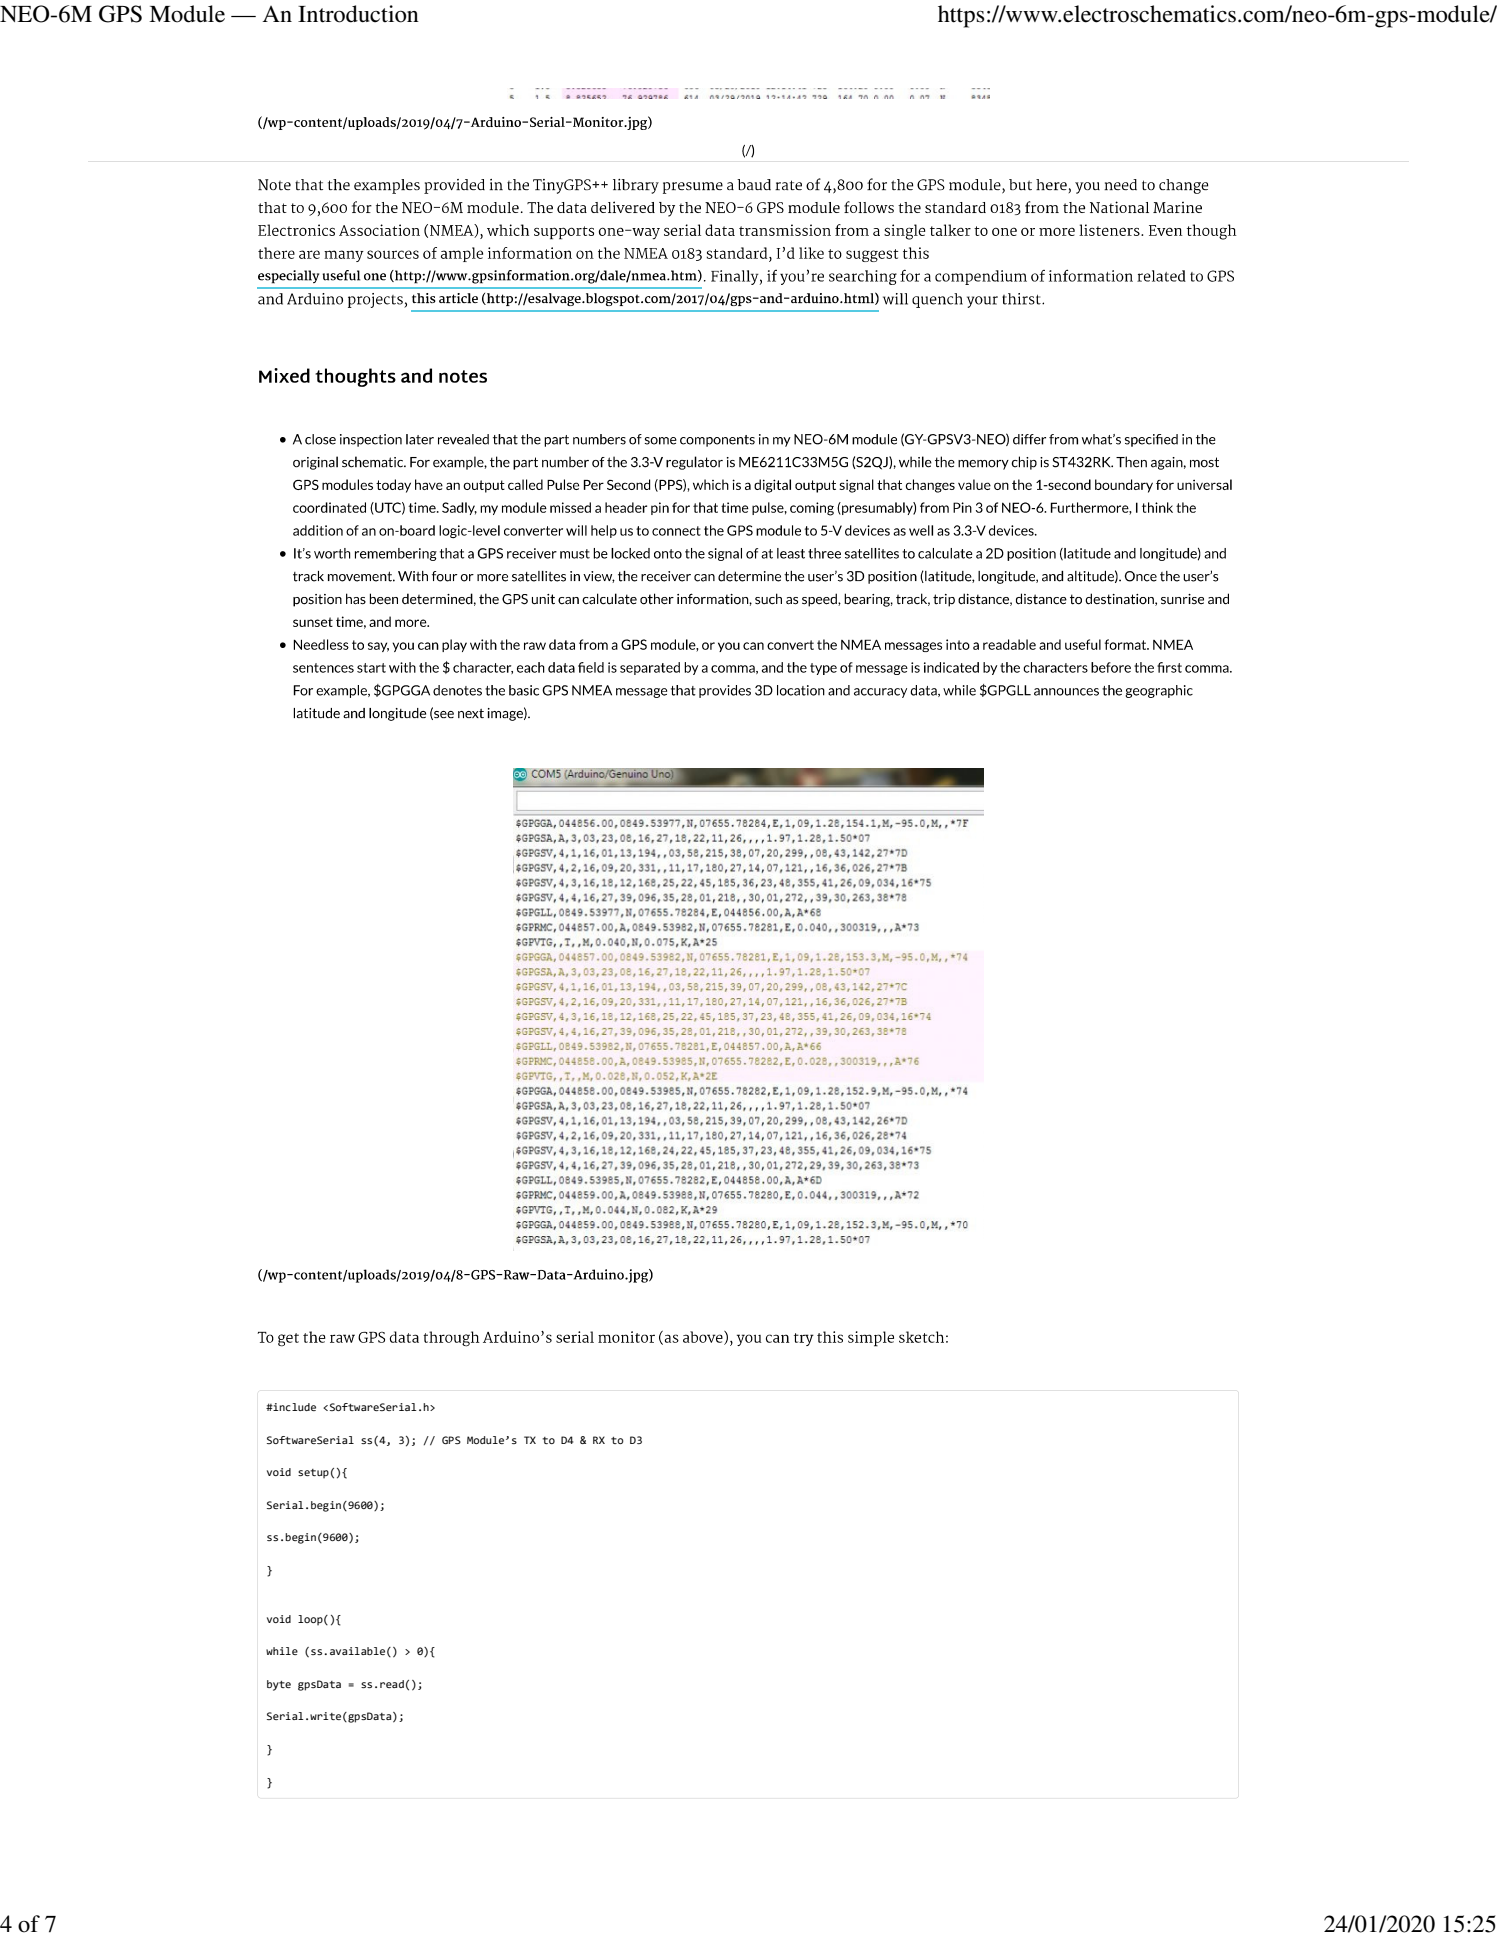
[picture p27: page 4]
#include <SoftwareSerial.h>; void setup(){; Serial.begin(9600);; ss.begin(9600);; void loop(){

SoftwareSerial ss(4, 3); // GPS Module’s TX to D4 & RX to D3

while (ss.available() > 0){

byte gpsData = ss.read();

Serial.write(gpsData);

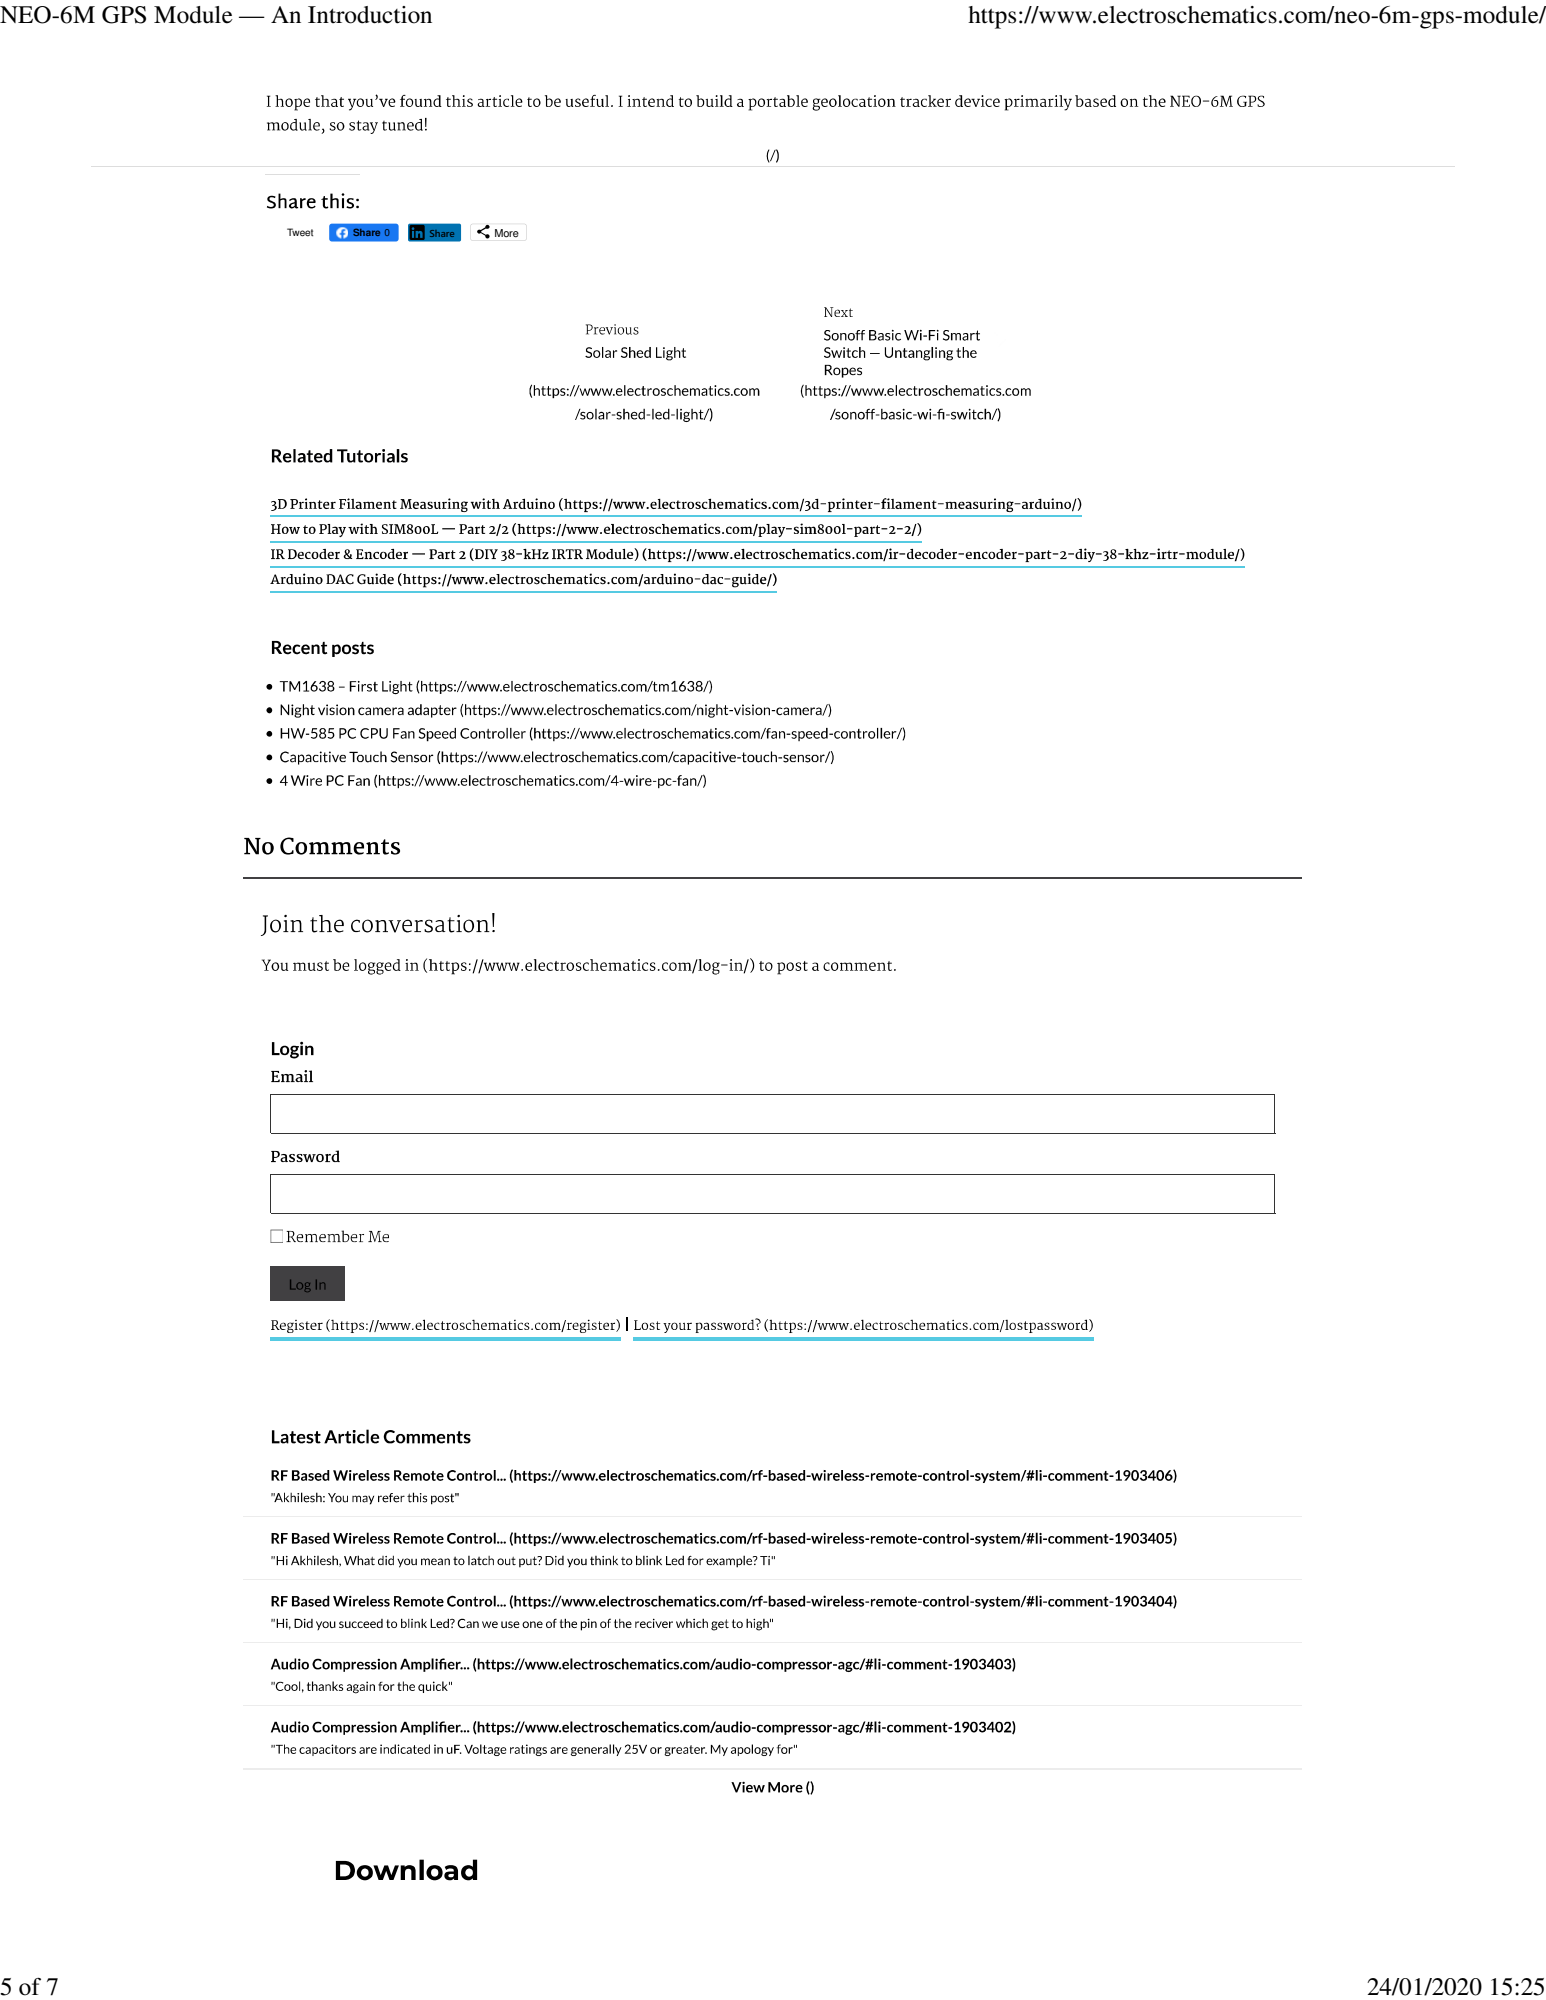
[picture p28: page 5]
Tweet; Share 0; Share; More

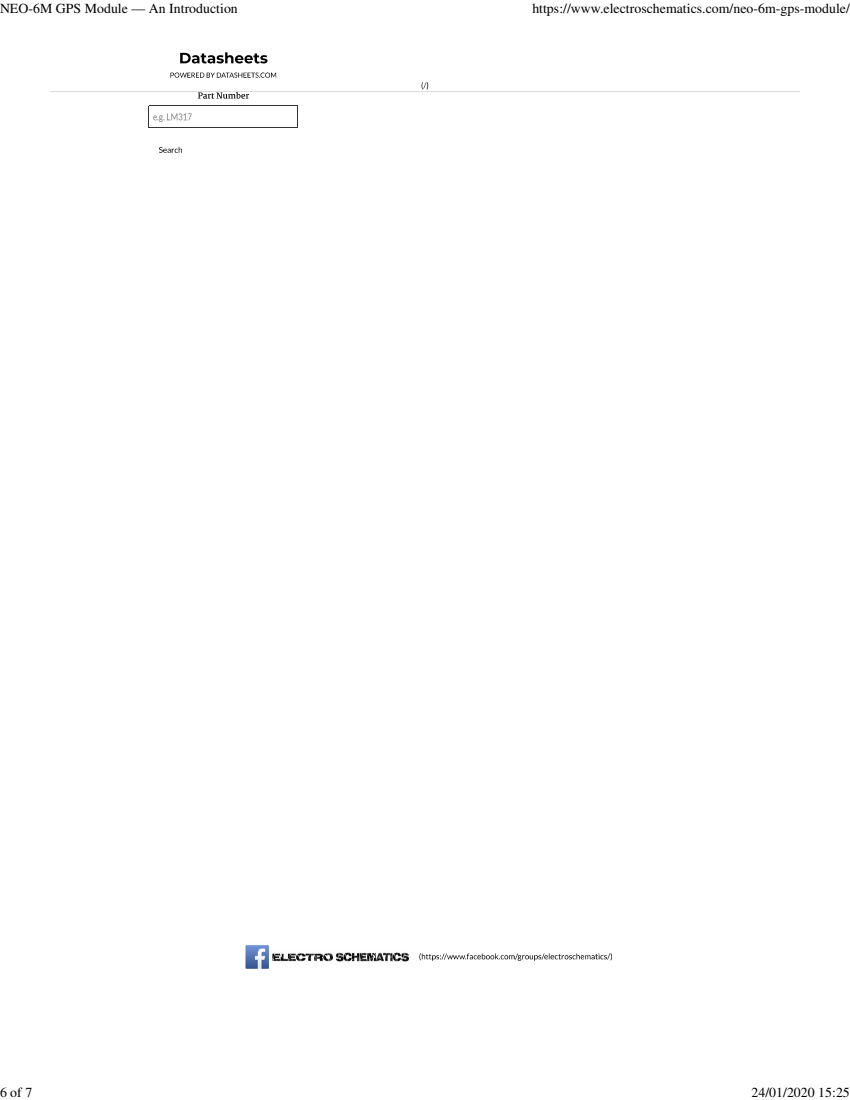
[picture p29: page 6]

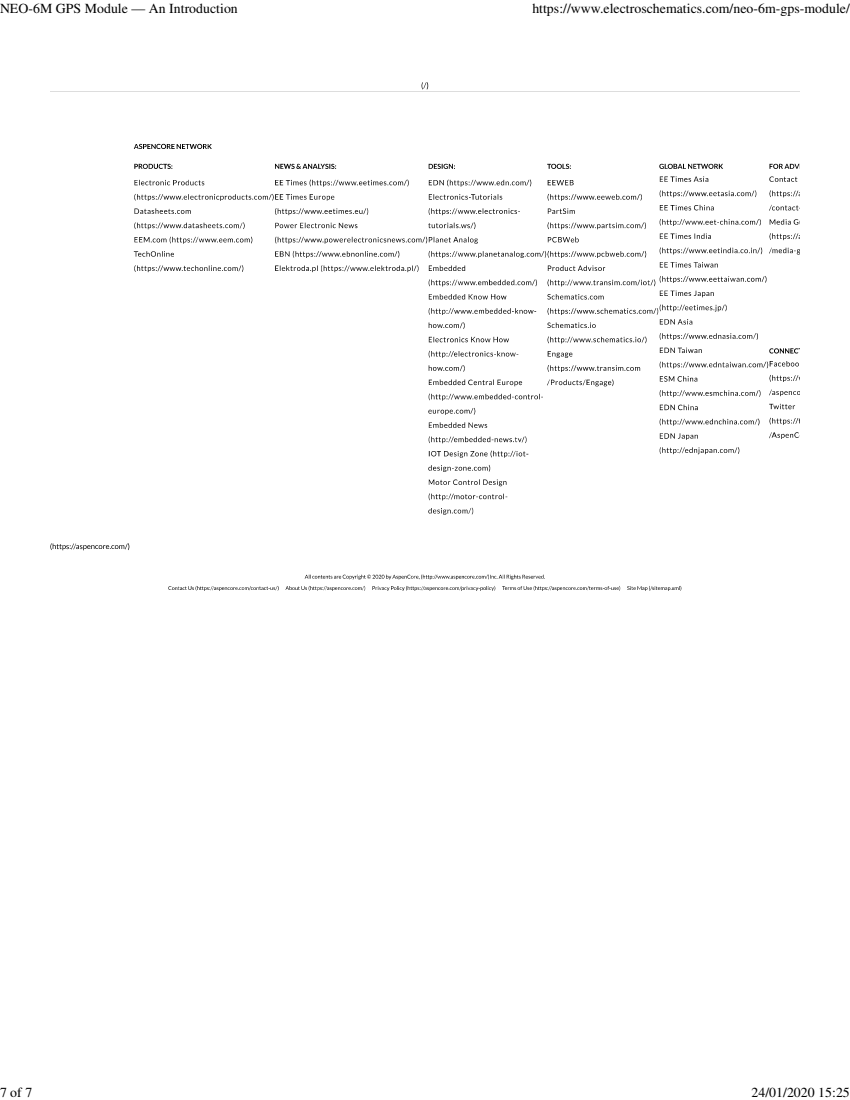
[picture p30: page 7]
