rzele/TCC-Caixa-Preta/schemas/CPU.pdf

### USB P4

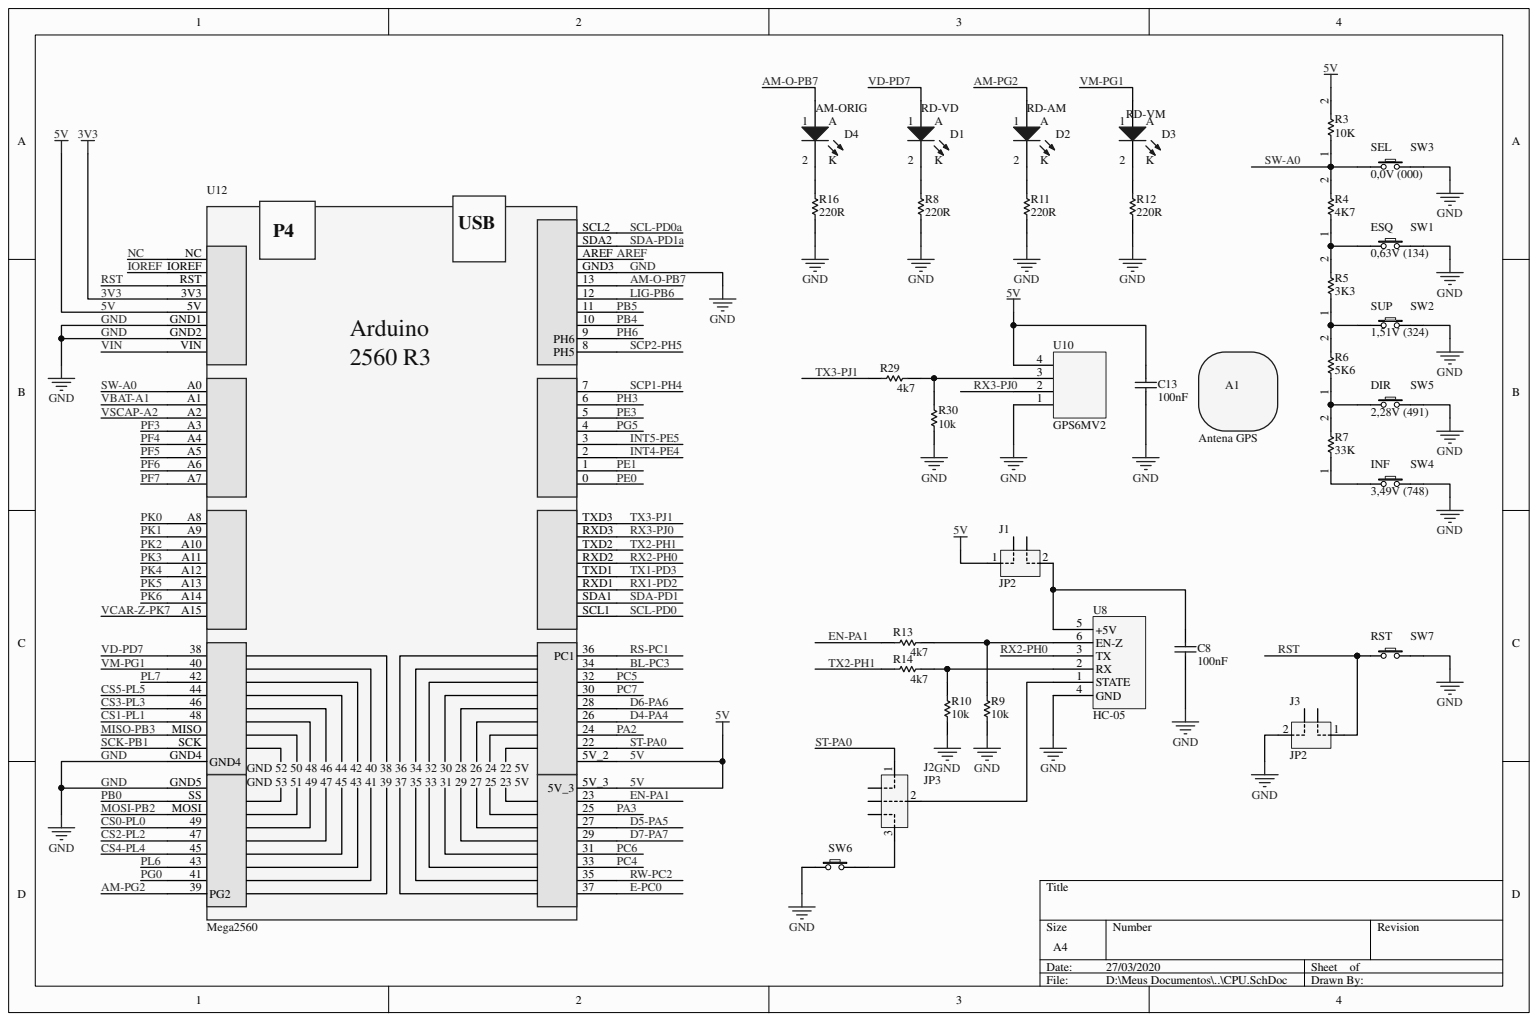
[picture p31: page 1]
