rzele/TCC-Caixa-Preta/schemas/CXP 1p3/Memo.pdf

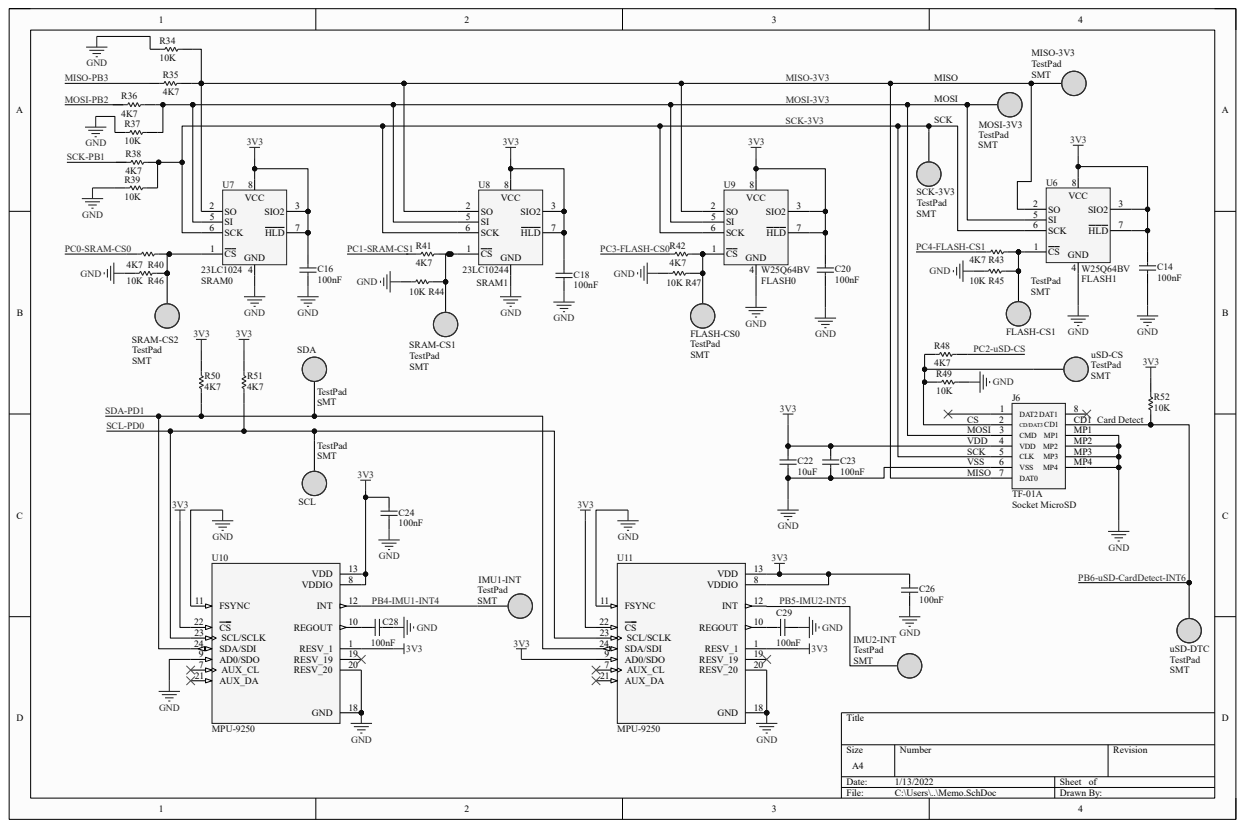
[picture p32: page 1]
