rzele/TCC-Caixa-Preta/schemas/CXP 1p3/Micro.pdf

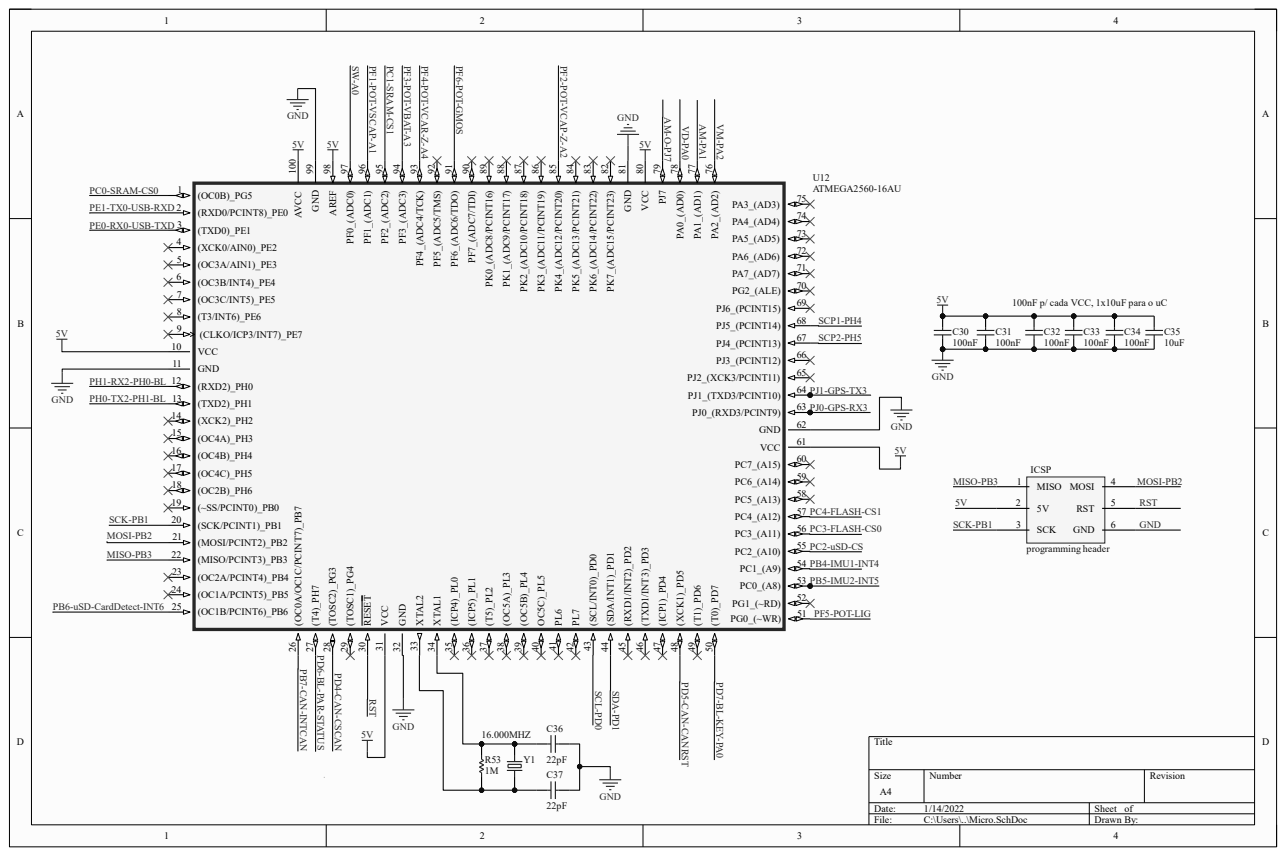
[picture p33: page 1]

100nF p/ cada VCC, 1x10uF para o uC
