rzele/TCC-Caixa-Preta/schemas/CXP 1p3/Perif.pdf

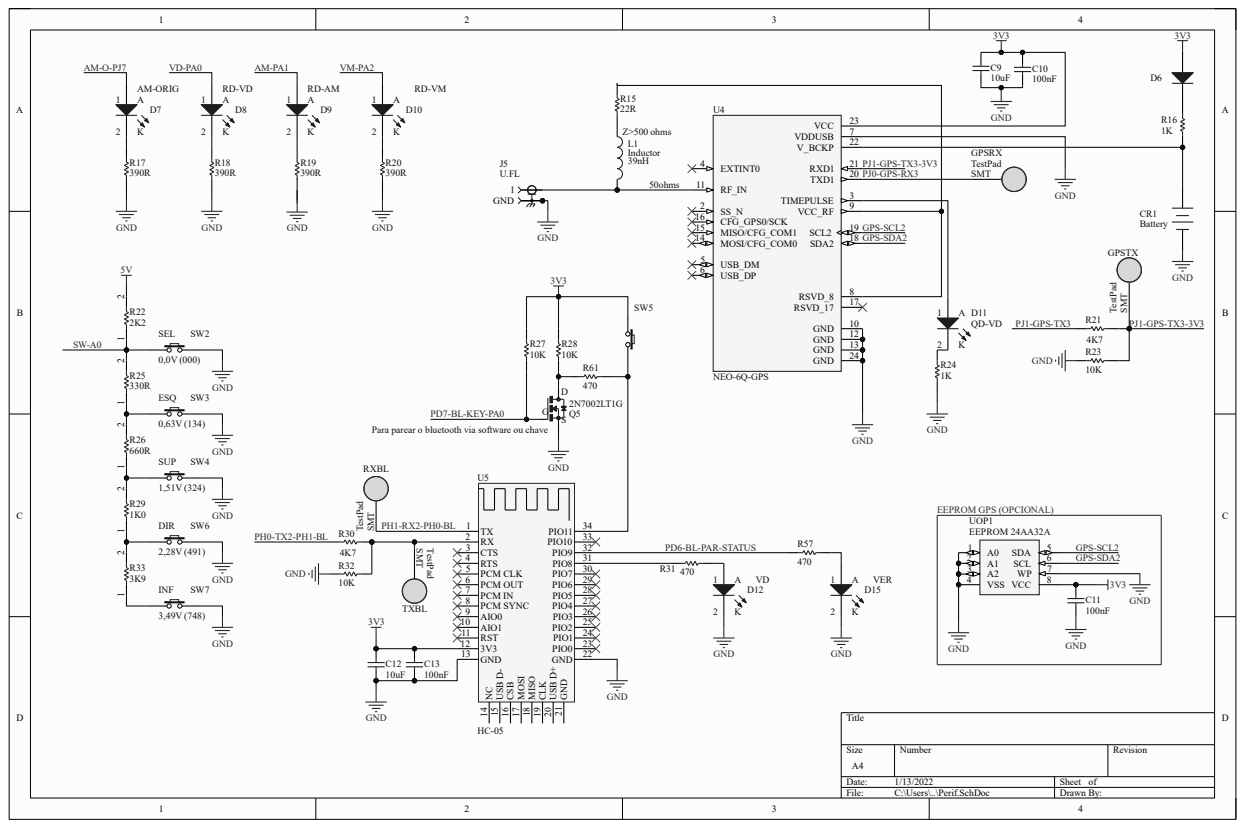
[picture p34: page 1]

Para parear o bluetooth via software ou chave
