rzele/TCC-Caixa-Preta/schemas/CXP 1p3/Pot.pdf

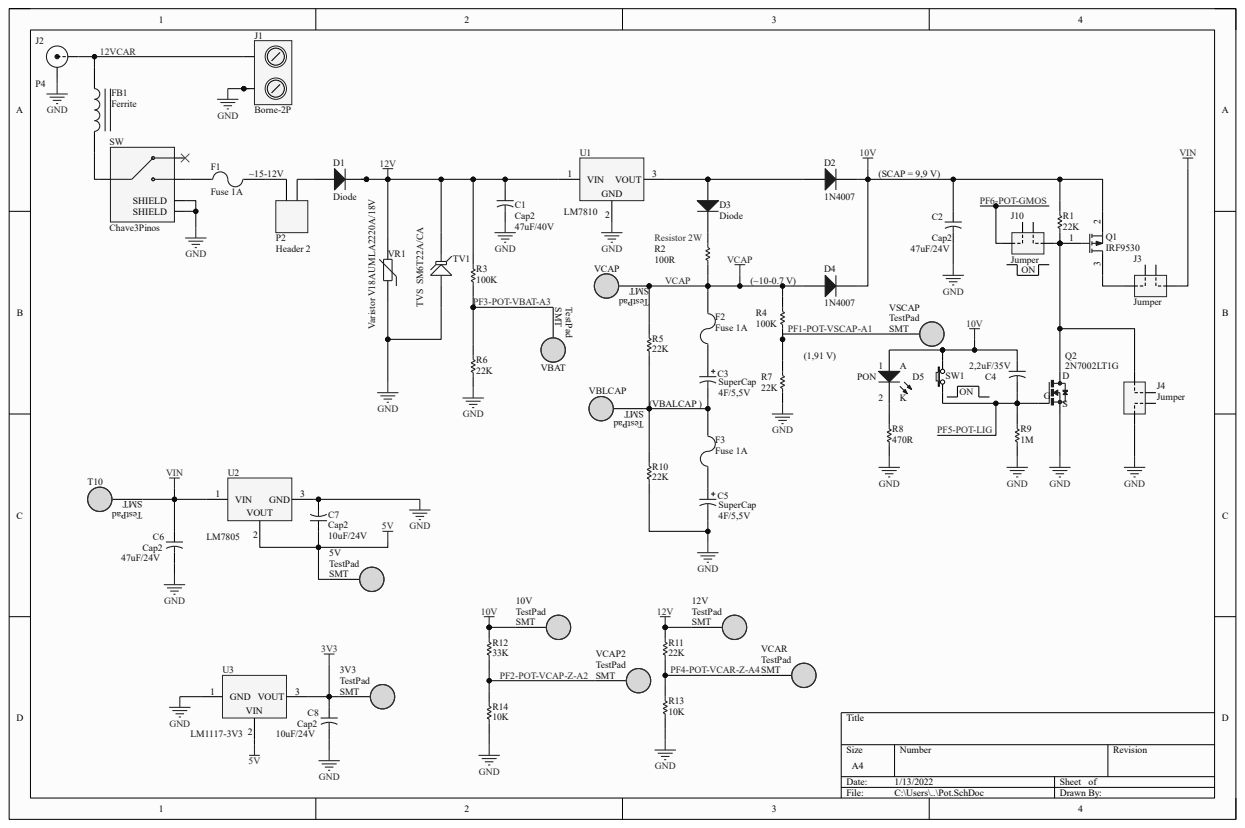
[picture p35: page 1]
