rzele/TCC-Caixa-Preta/schemas/Conect.pdf

## ARDUINO MEGA

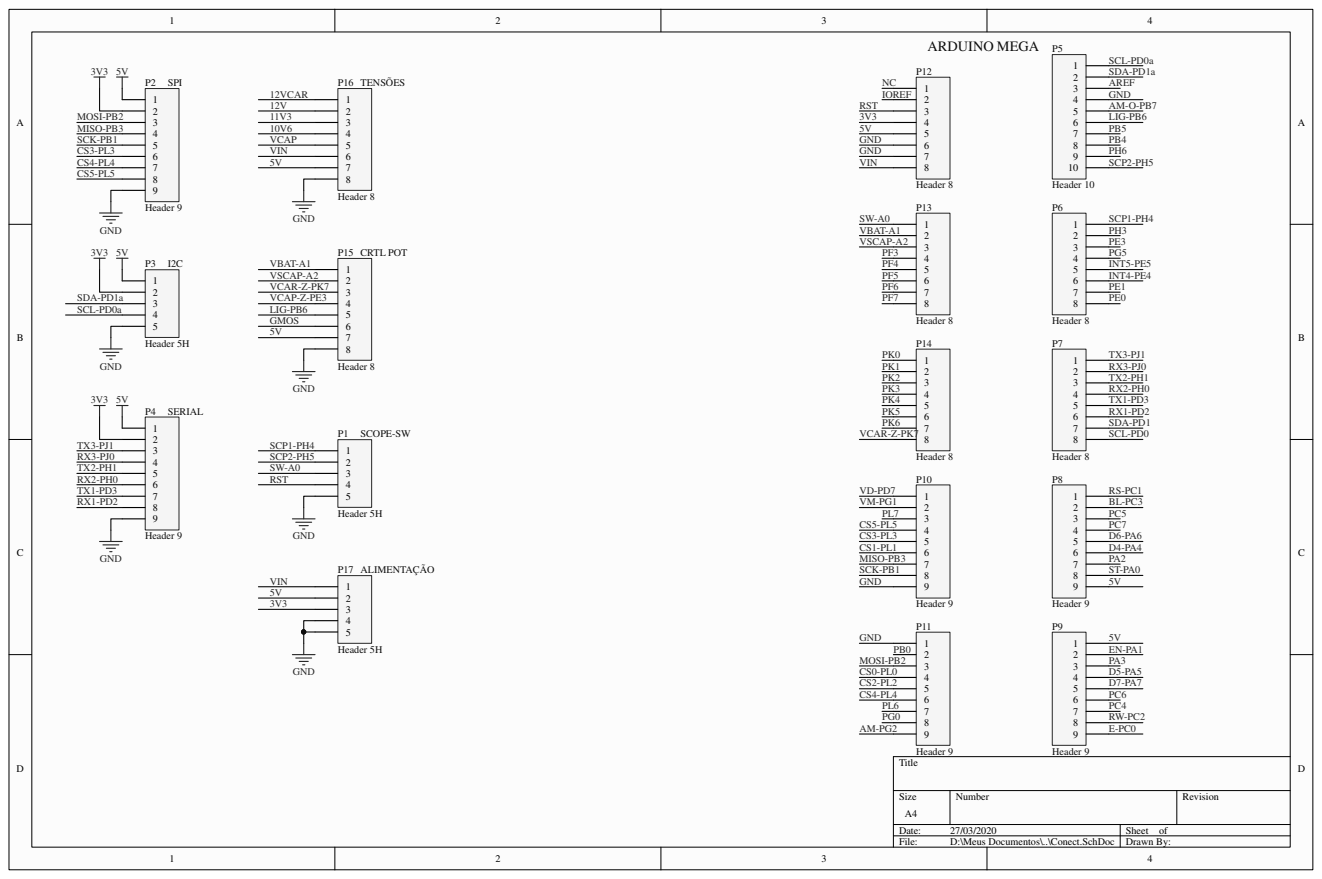
[picture p36: page 1]
