rzele/TCC-Caixa-Preta/schemas/Memo.pdf

## ALTERAR

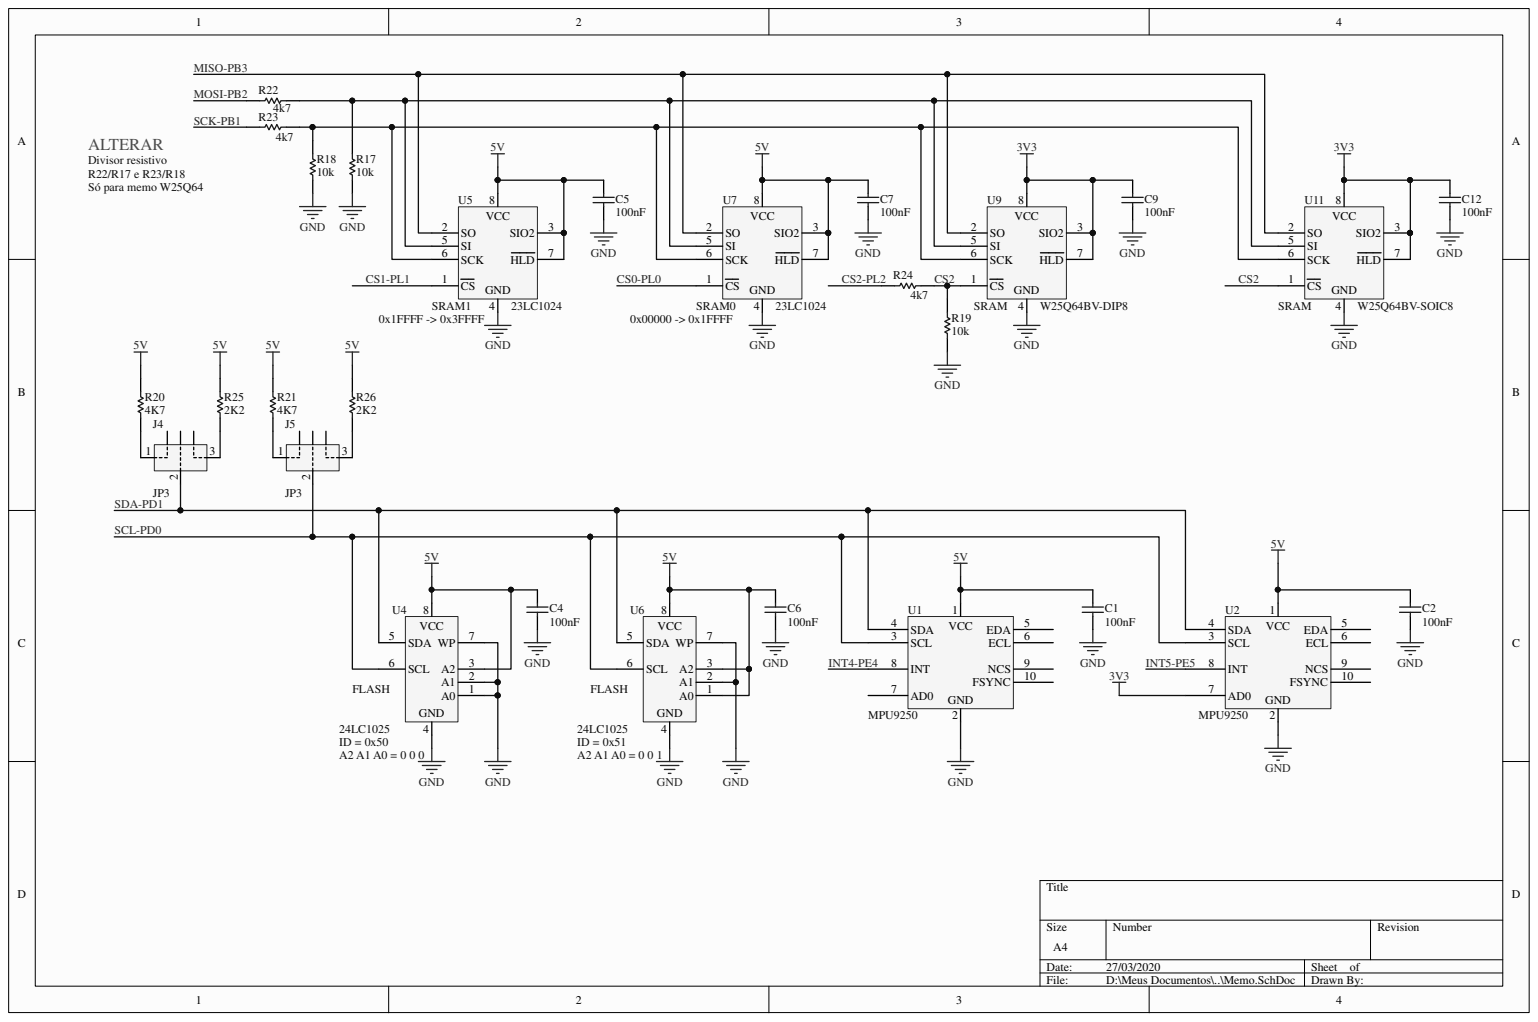
[picture p37: page 1]
