rzele/TCC-Caixa-Preta/schemas/Pot.pdf

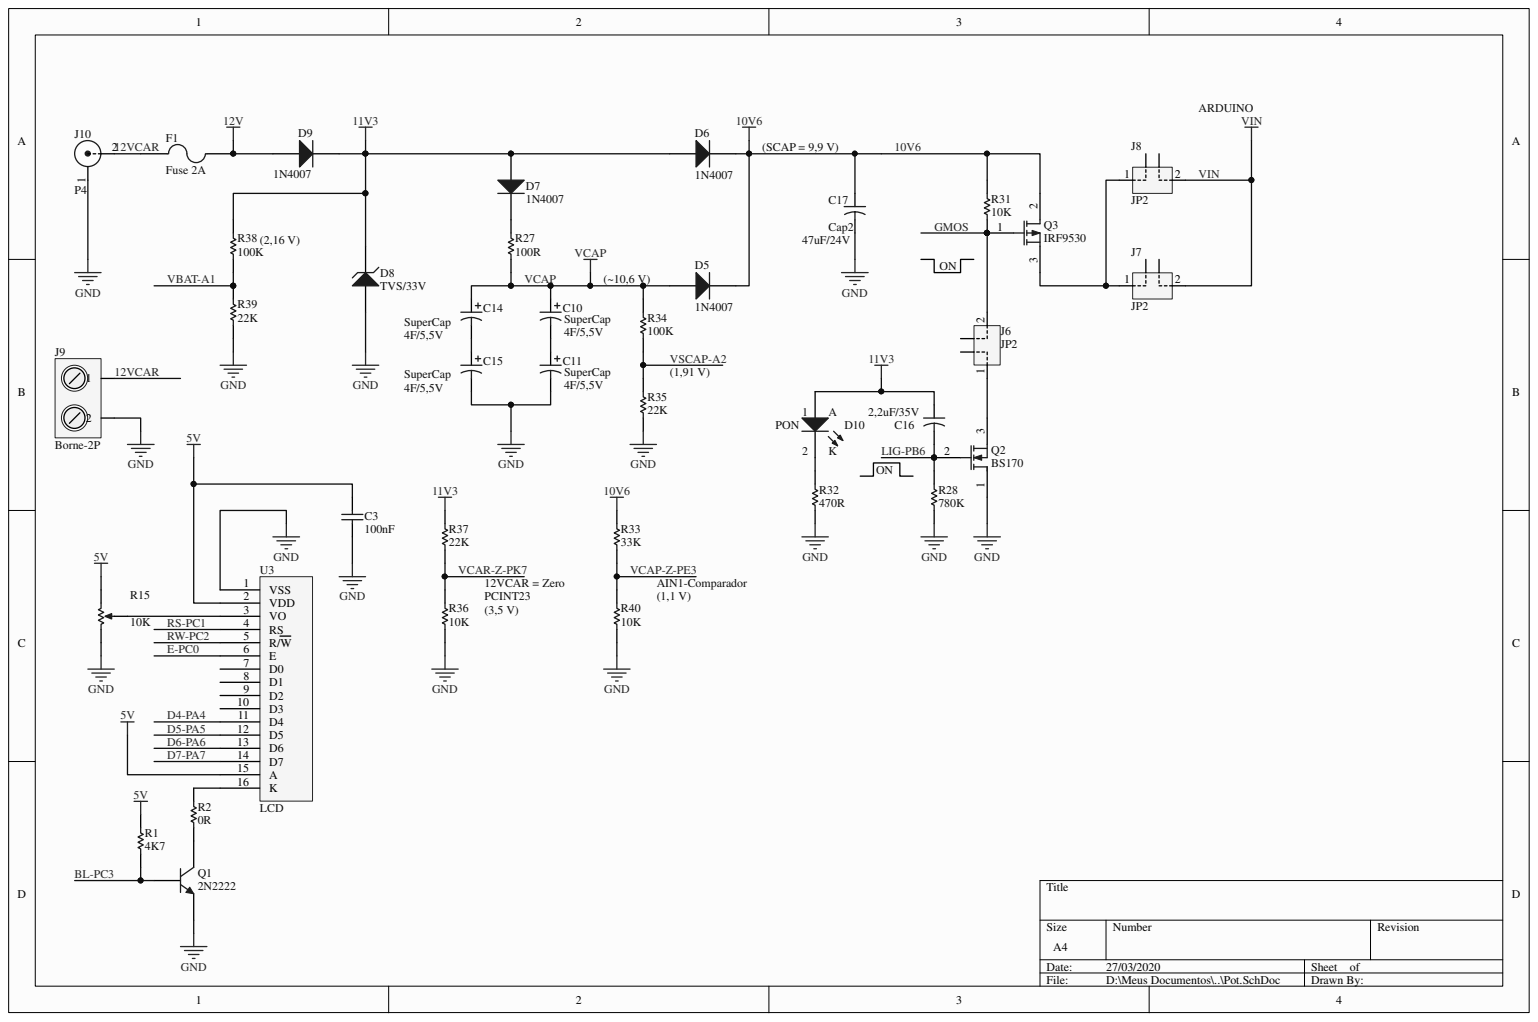
[picture p38: page 1]
