rzele/TCC-Caixa-Preta/(commit log)

2020-03-26 Add files via upload
    (26/03/2020) Ponto de partida para a Caixa Preta.
2020-04-04 Add files via upload
    04/04/2020, 16:25 hs --> Programa corrigido (erro estava no string.s, função str_dec16()). Agora tudo funciona!
    [CXP.ino, h-Strings.ino]
2020-05-19 Adicionado filtro de kalman e leitura via arquivo
2020-05-22 apagando para atualizar
2020-05-23 adicionado filtro de madgwick
2020-06-08 atualizado arquivos do ino com dados de junho
2020-07-04 mudado formato de plotagem, e adicionado plotagem com carro em 3d
2020-07-04 Versão CPX ino inicio de julho
2020-07-18 - arrumado bug na rotação do carro com angulos de euler - alterado estrutura de leitura de arquivo
2020-08-04 mag calibration with matlab
2020-08-06 plots do magnetometro sem compensação de tilt
2020-08-11 versão com api de comunicação serial e bluethoot integradas
2020-09-14 added mag to all filters
2020-09-19 calculating velocity with comp filter
2021-03-06 fix for kalman filter
2021-03-07 added new filter to raw data
2021-04-08 insert bias and noise
2021-04-12 fix for commit 98ba68a at calculate gyroabsolute
2021-04-13 fix for datafactory generate gyro
2021-05-02 refactor for datafactory generate gyro
2021-05-02 fix for complementary filter, using absolute angle as input
2021-05-02 join 3 kalman filter in one
2021-05-02 fix for kalman filter, using absolute estimative
2021-05-04 new simulated data for pitch roll in sequence of 90 deg
2021-05-08 normalize magnetometer data too
2021-05-08 increase simulated gyro drift
2021-05-08 defined better params for fusion filters
